daffa261109/twotrash/docs/pcb/output/pdf/02-tembaga-bawah-inspeksi.pdf

# SISI TEMBAGA - HANYA UNTUK INSPEKSI

TT-PZ2 / 140 x 100 mm / single-sided copper / no mains

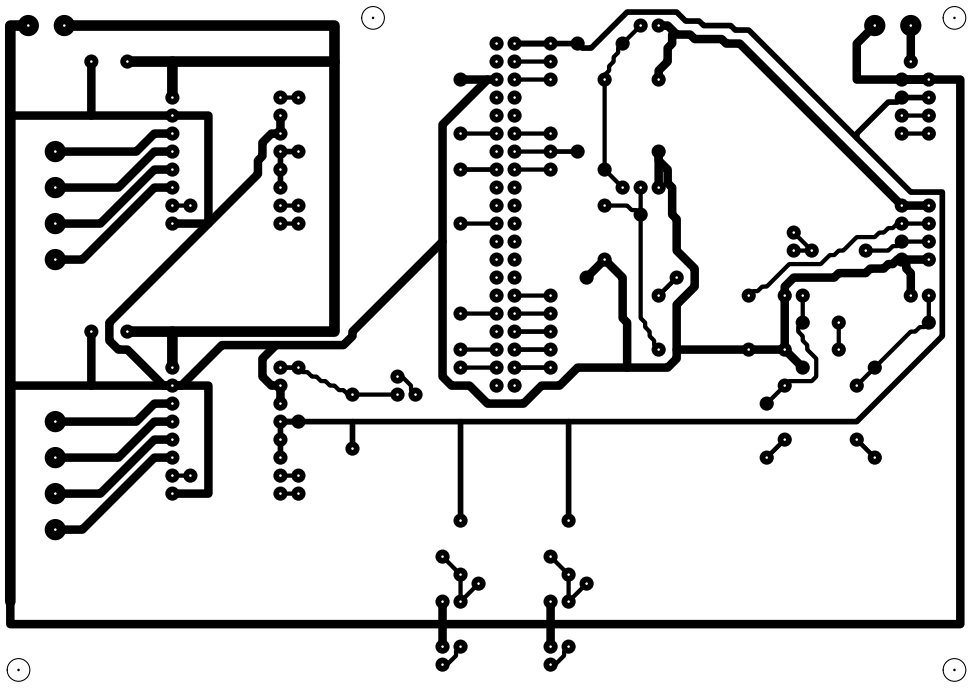
[picture p2: figure]

CALIBRATION: exactly 50 mm

Board outline 140 x 100 mm. A4 / Actual size / 100%.

Printer laser. Actual size 100%. Matikan Fit / Shrink. JANGAN mirror lagi. Hitam = tembaga dipertahankan. Titik putih kecil = pusat bor.
Bandingkan gambar ini dengan sisi tembaga SETELAH transfer.
Use 03-komponen-dan-bor.pdf for component side, drill sizes and wire jumpers. Required insulated wire jumpers: 22. Do not omit them.
Prototipe: cocokkan modul nyata dan periksa kontinuitas sebelum memberi daya.
