daffa261109/twotrash/docs/3d/external-gears/mekanisme-tanpa-flap.png

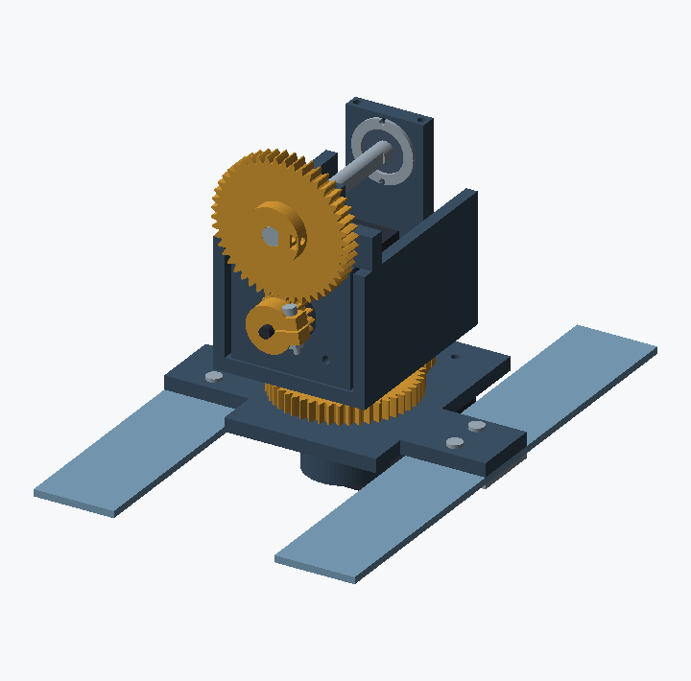
docs/3d/external-gears/mekanisme-tanpa-flap.png
