daffa261109/twotrash/docs/3d/external-gears/previews/flap-atas.png

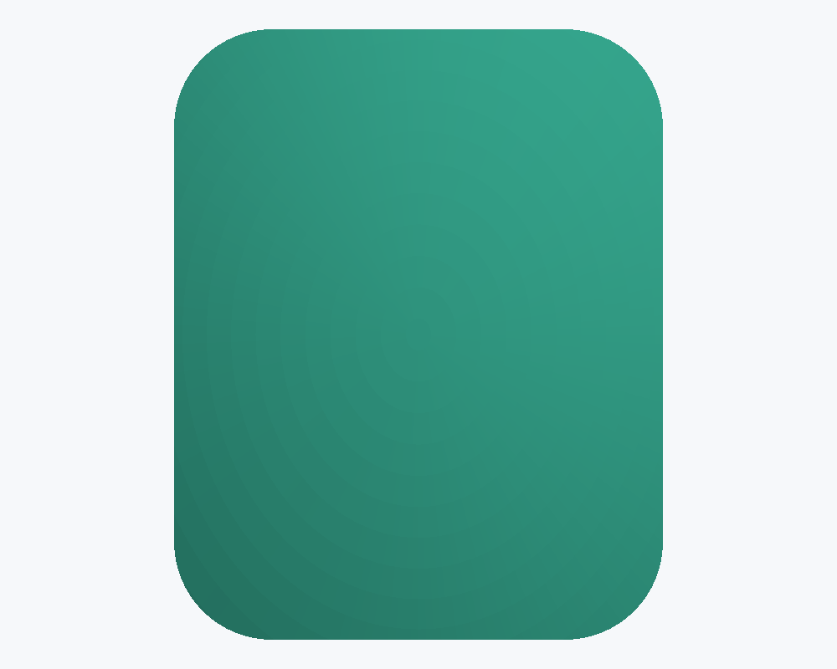
docs/3d/external-gears/previews/flap-atas.png
