daffa261109/twotrash/docs/3d/external-gears/previews/flap-bawah-miring.png

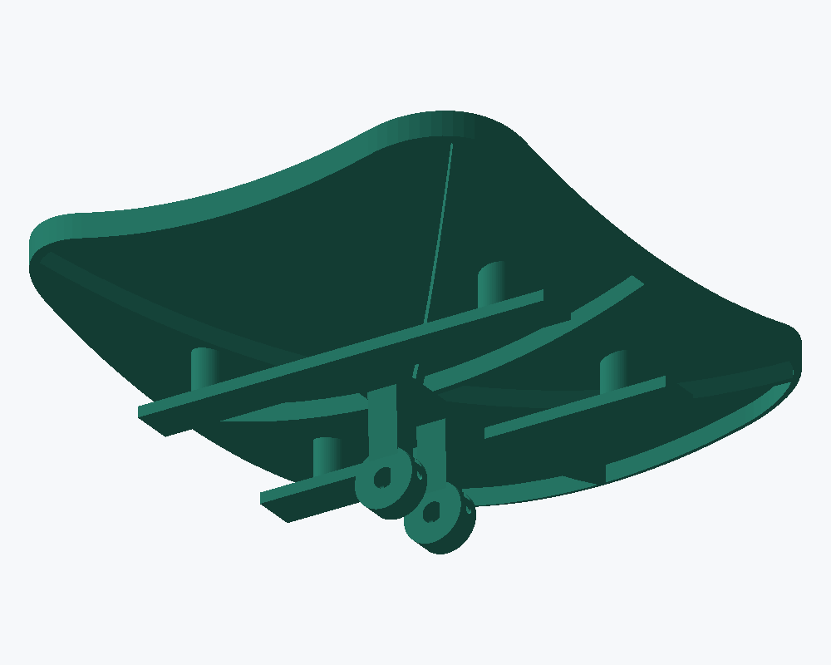
docs/3d/external-gears/previews/flap-bawah-miring.png
