daffa261109/twotrash/docs/3d/external-gears/previews/flap-miring.png

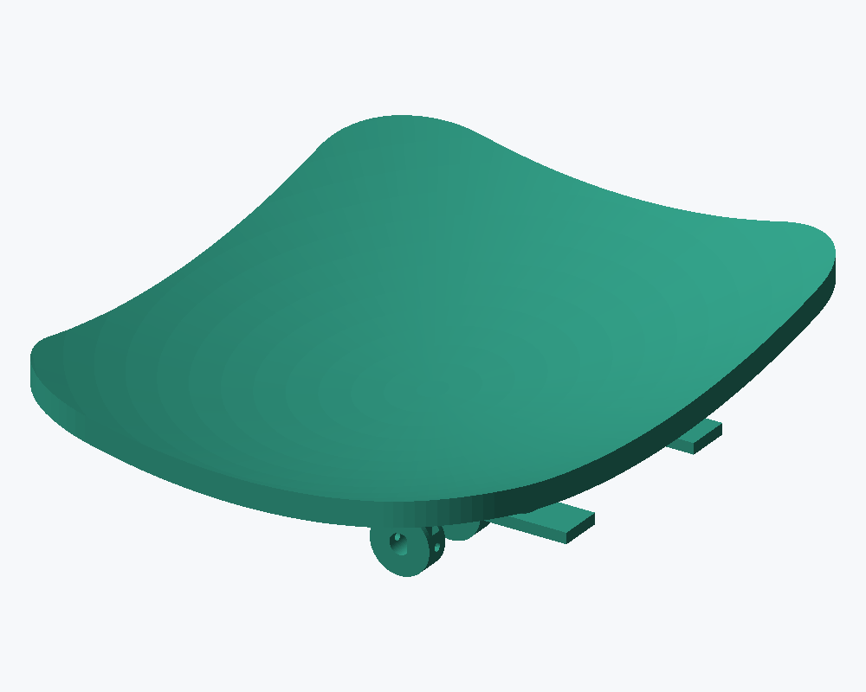
docs/3d/external-gears/previews/flap-miring.png
