daffa261109/twotrash/docs/3d/external-gears/previews/frame-dudukan-bak-atas.png

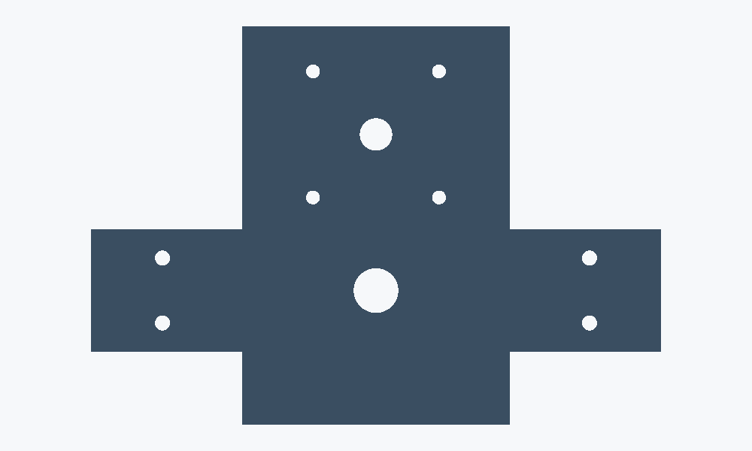
docs/3d/external-gears/previews/frame-dudukan-bak-atas.png
