daffa261109/twotrash/docs/3d/external-gears/previews/pinion-poros-bulat.png

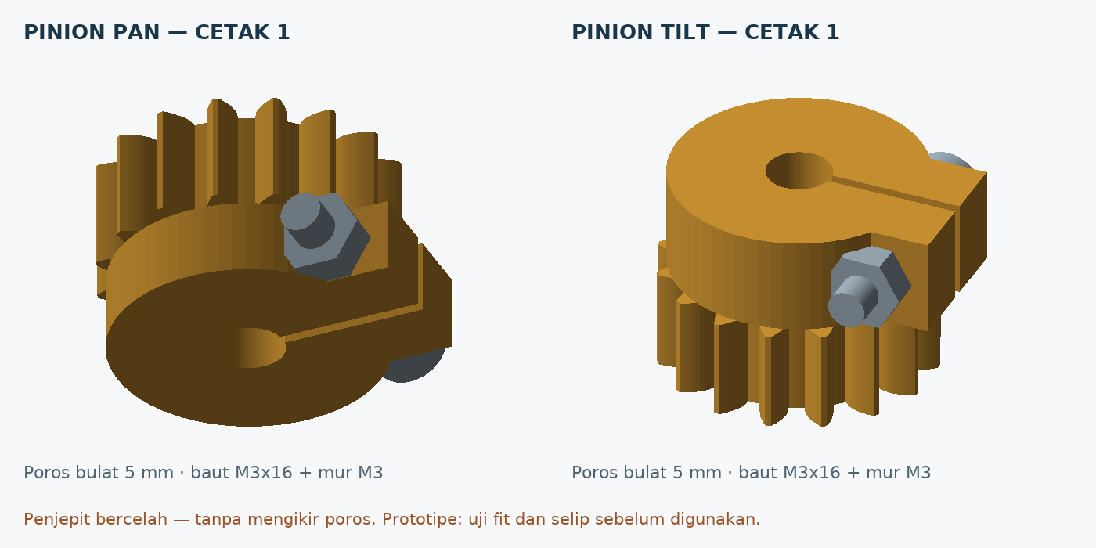
docs/3d/external-gears/previews/pinion-poros-bulat.png
