daffa261109/twotrash/docs/3d/external-gears/rakitan-3d.png

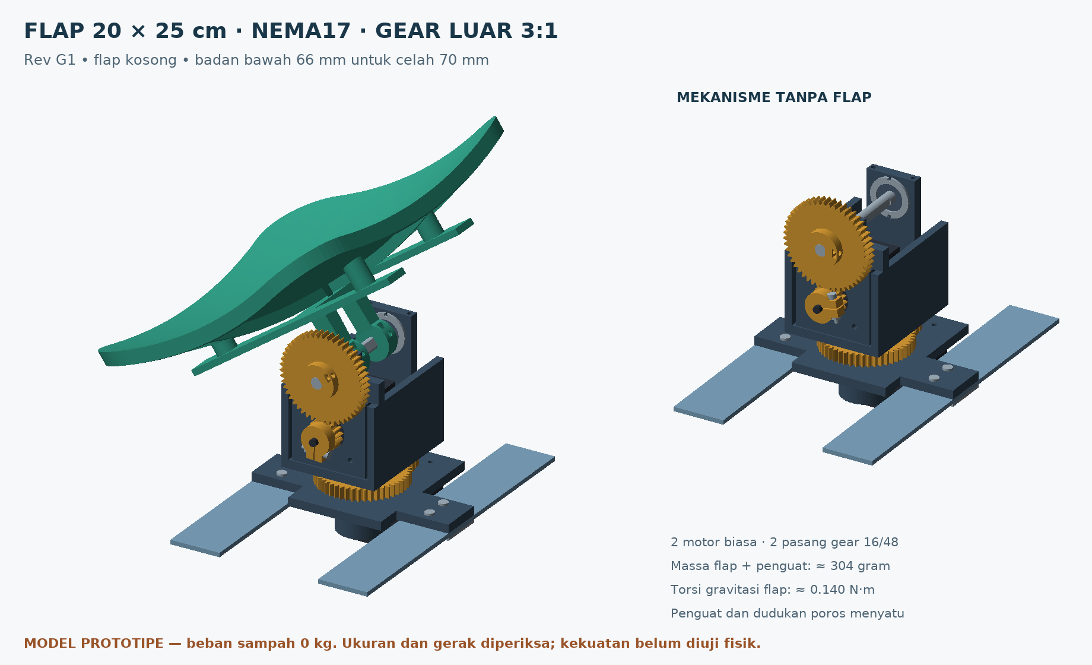
docs/3d/external-gears/rakitan-3d.png
