daffa261109/twotrash/docs/pcb/previews/01-transfer-toner-1to1-p1.png

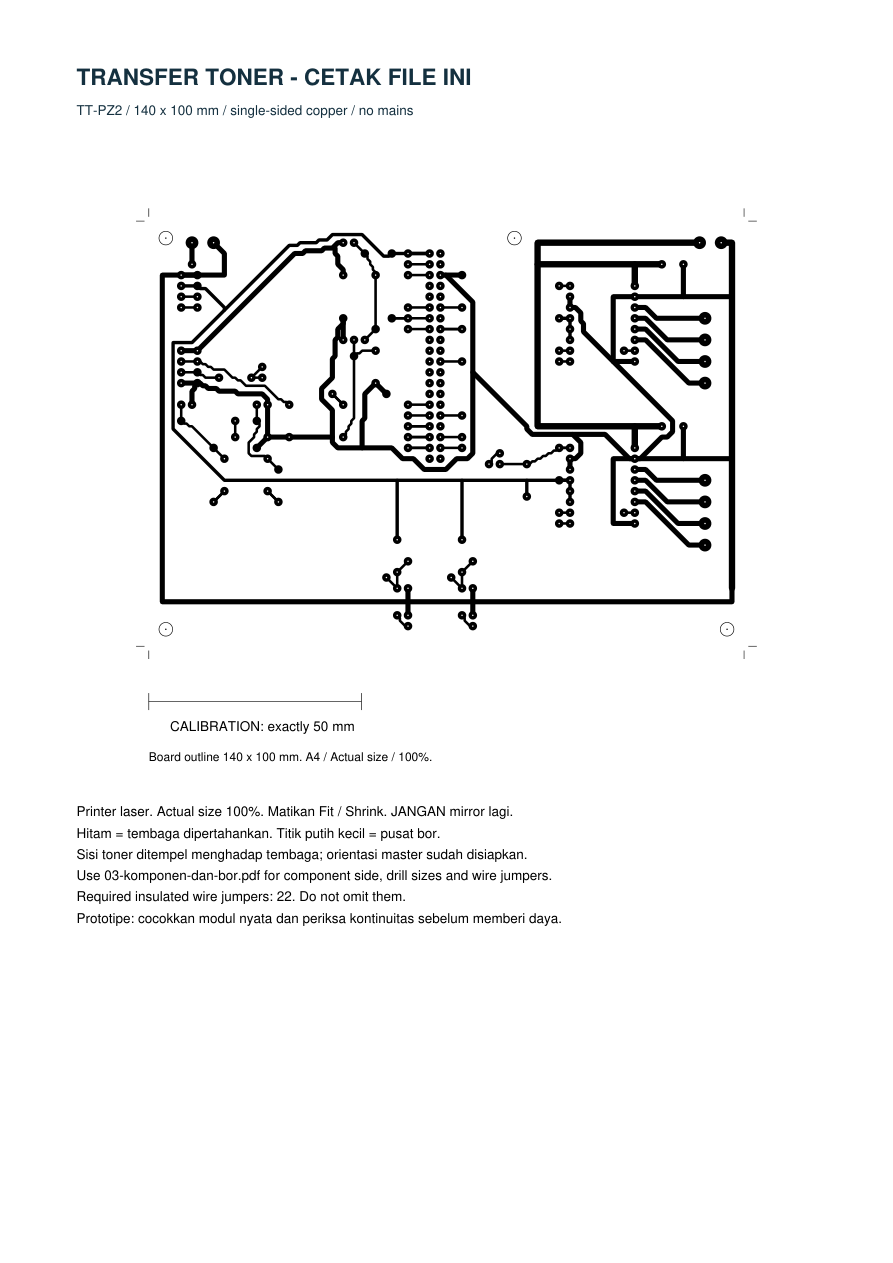
docs/pcb/previews/01-transfer-toner-1to1-p1.png
