daffa261109/twotrash/docs/pcb/previews/02-tembaga-bawah-inspeksi-p1.png

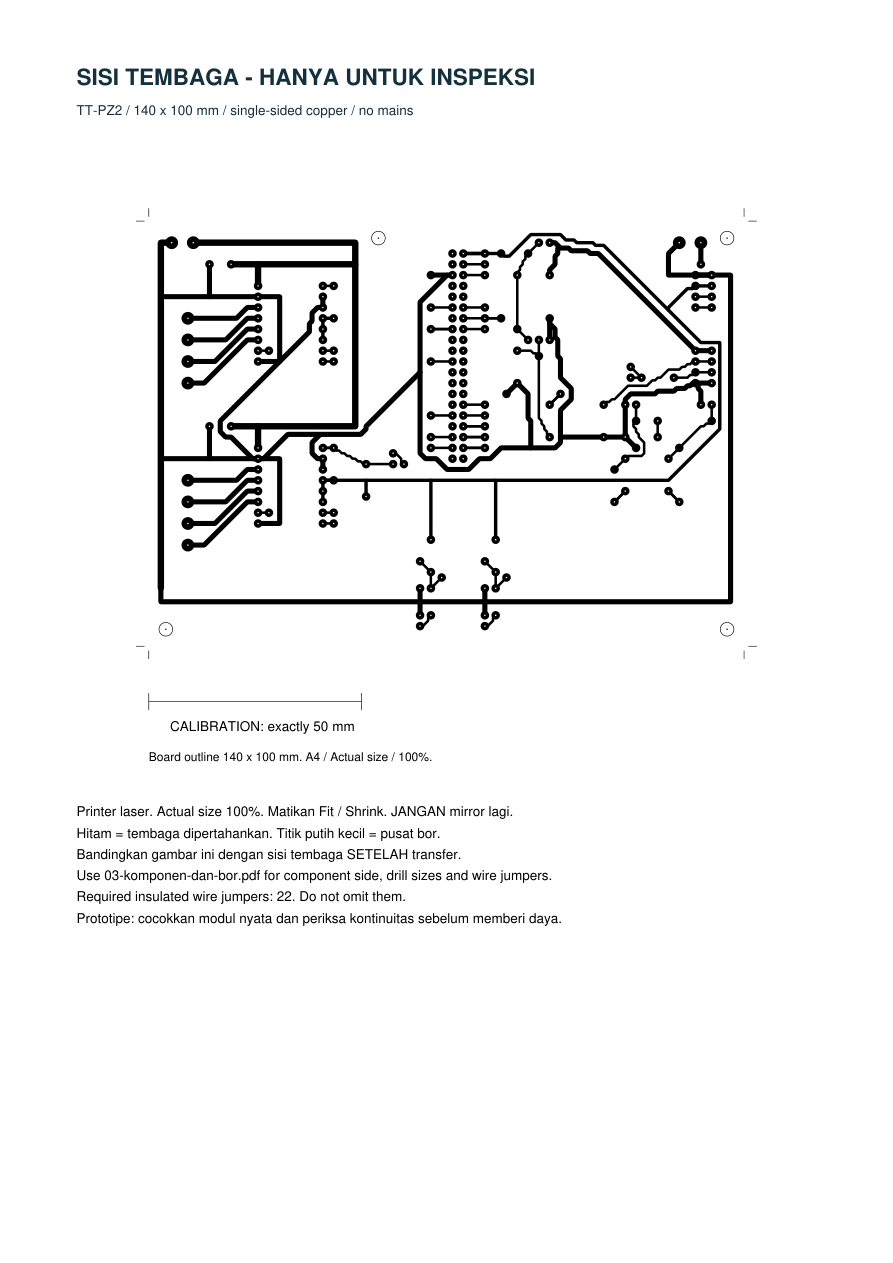
docs/pcb/previews/02-tembaga-bawah-inspeksi-p1.png
