daffa261109/twotrash/docs/pcb/previews/03-komponen-dan-bor-p4.png

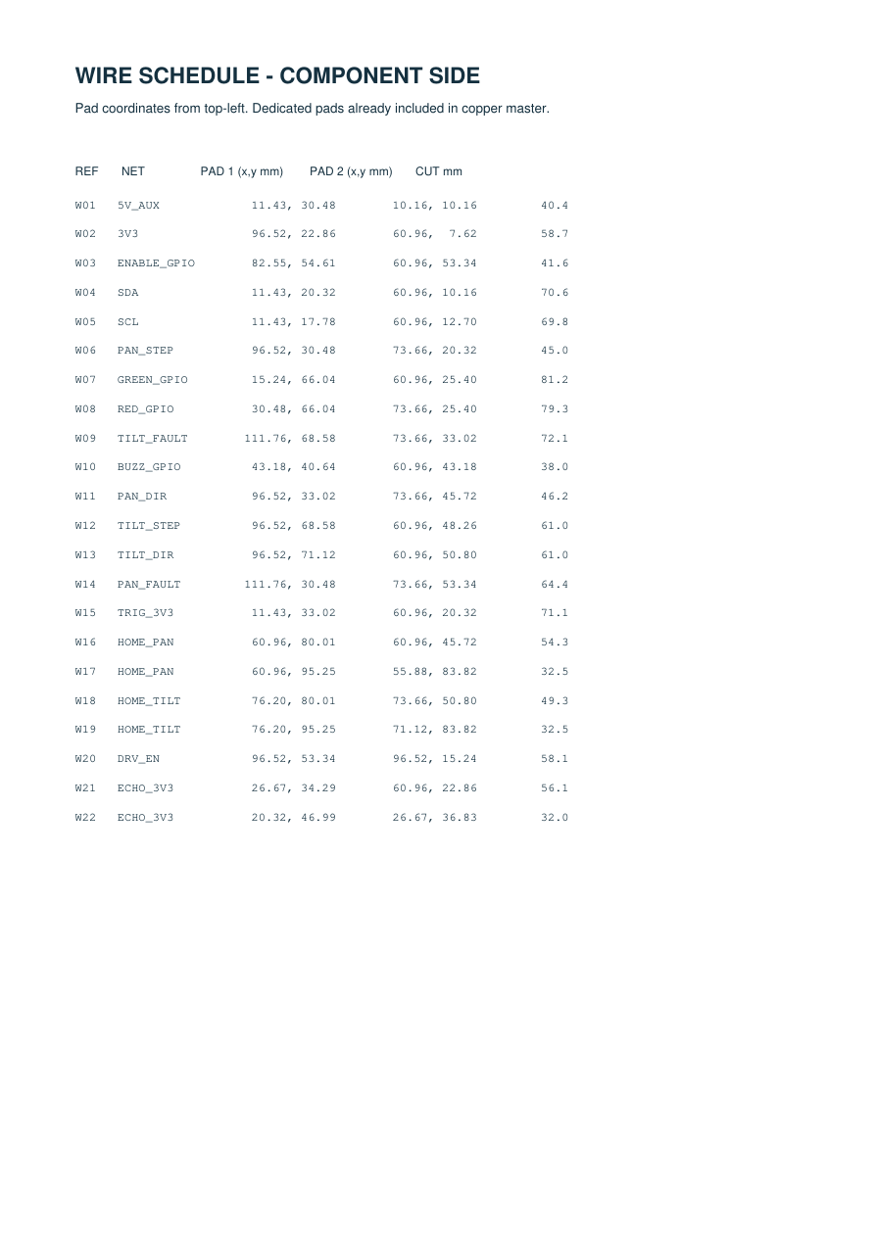
docs/pcb/previews/03-komponen-dan-bor-p4.png
