daffa261109/twotrash/docs/pcb/previews/03-komponen-dan-bor-p5.png

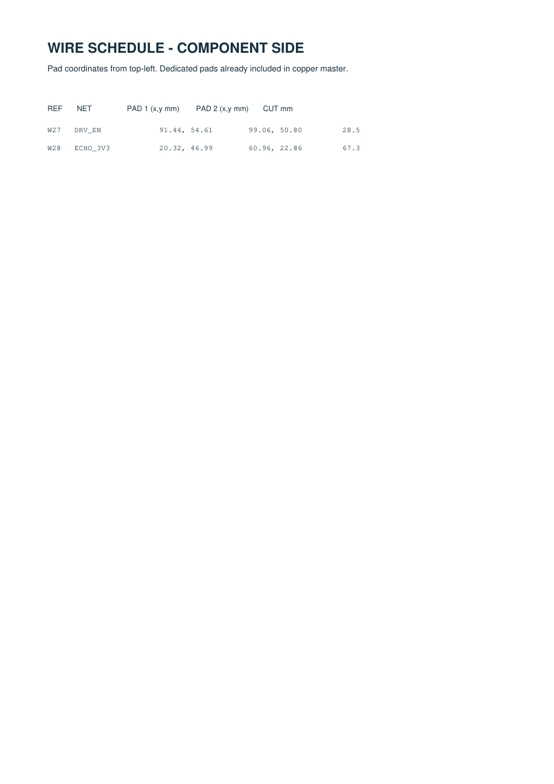
docs/pcb/previews/03-komponen-dan-bor-p5.png
