daffa261109/twotrash/docs/pcb/previews/04-peta-komponen-jelas-p2.png

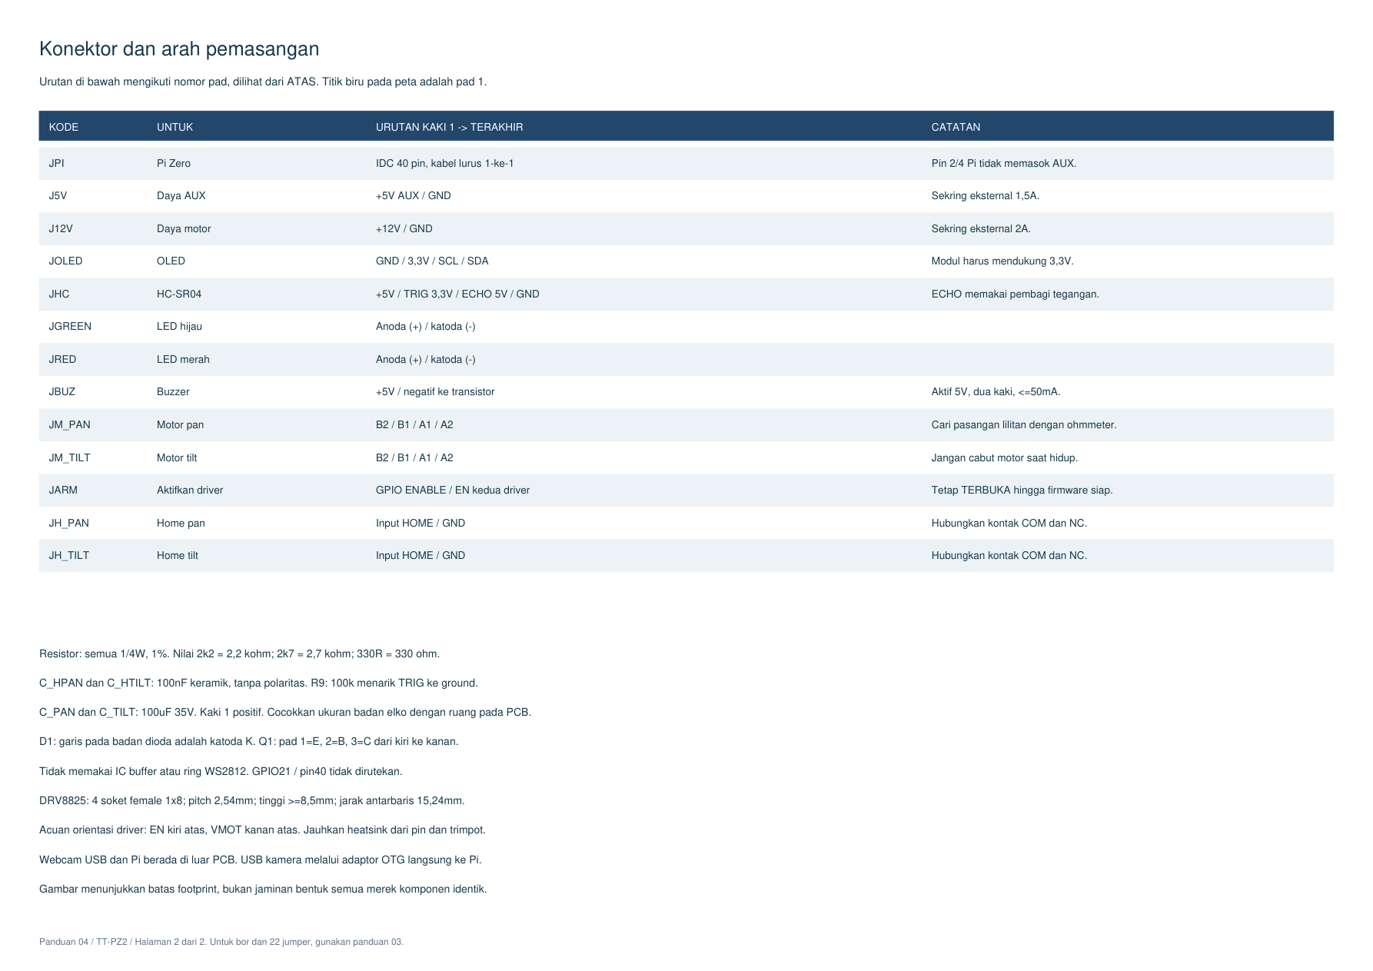
docs/pcb/previews/04-peta-komponen-jelas-p2.png
