daffa261109/twotrash/docs/pcb/previews/pcb-atas.png

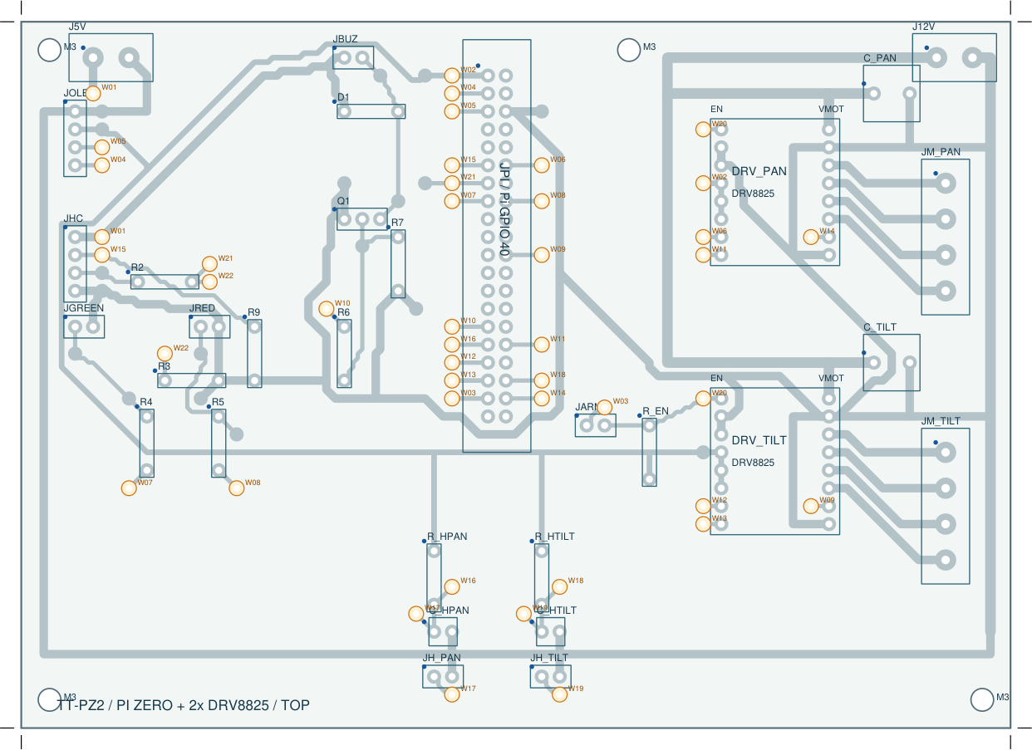
docs/pcb/previews/pcb-atas.png
