daffa261109/twotrash/docs/3d/external-gears/stl/caps.stl

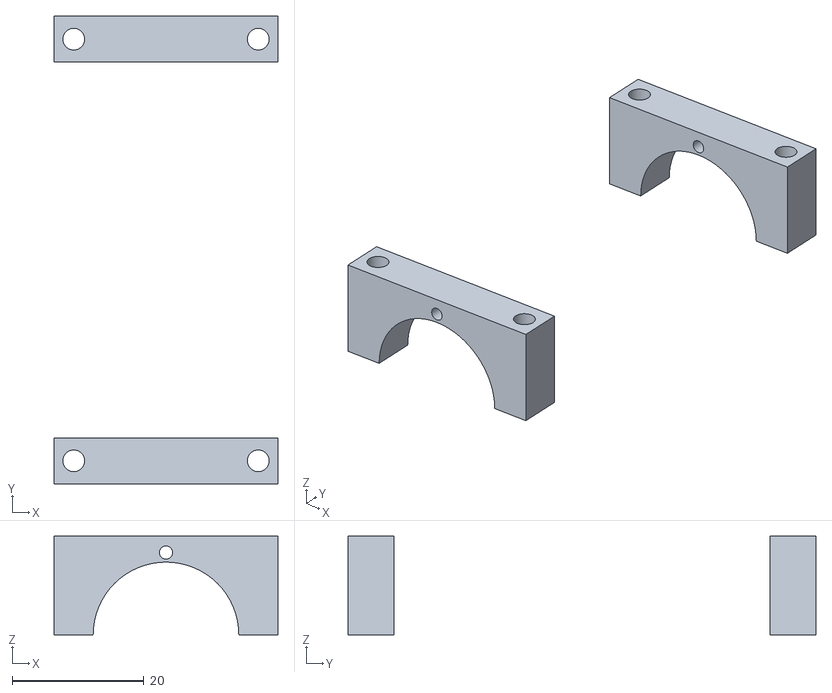
[picture p21: CAD file, 2026-10-26]
docs/3d/external-gears/stl/caps.stl
34.0 x 71.0 x 15.0
