daffa261109/twotrash/docs/3d/external-gears/stl/cetak/frame.stl

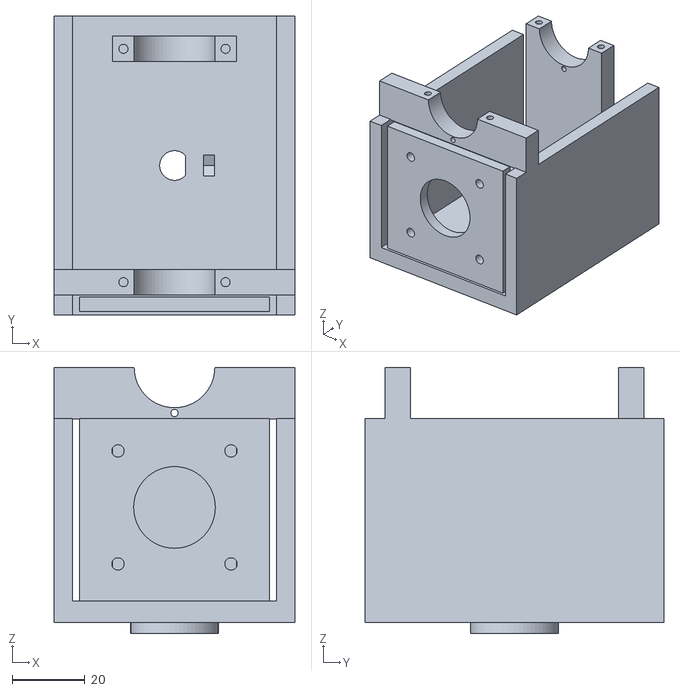
[picture p22: CAD file, 2026-10-26]
docs/3d/external-gears/stl/cetak/frame.stl
66.0 x 82.0 x 73.0
