daffa261109/twotrash/docs/3d/external-gears/stl/referensi/pinion_tilt_fastener.stl

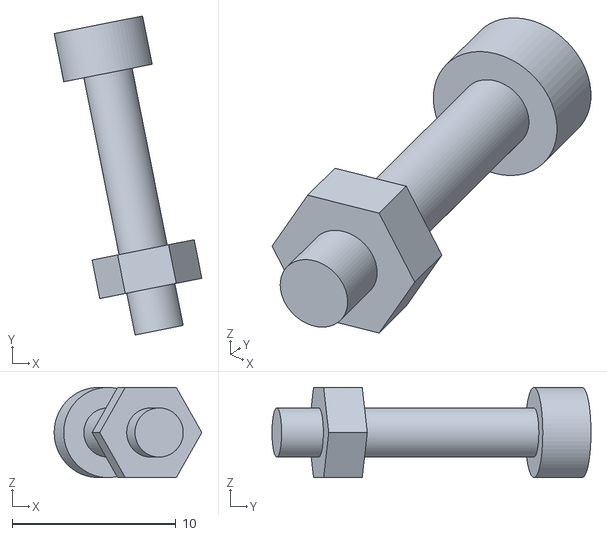
[picture p23: CAD file, 2026-10-26]
docs/3d/external-gears/stl/referensi/pinion_tilt_fastener.stl
9.01 x 19.5 x 5.50
