daffa261109/twotrash/docs/3d/flap-besi-tilt/stl/flap.stl

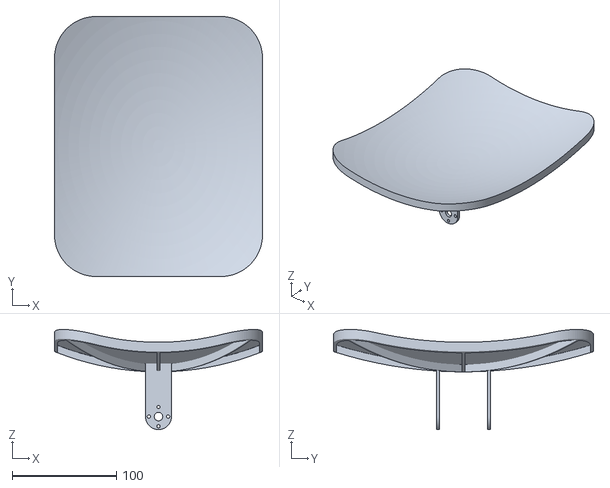
[picture p24: CAD file, 2026-10-26]
docs/3d/flap-besi-tilt/stl/flap.stl
200.0 x 250.0 x 96.3
