daffa261109/twotrash/docs/3d/flap.stl

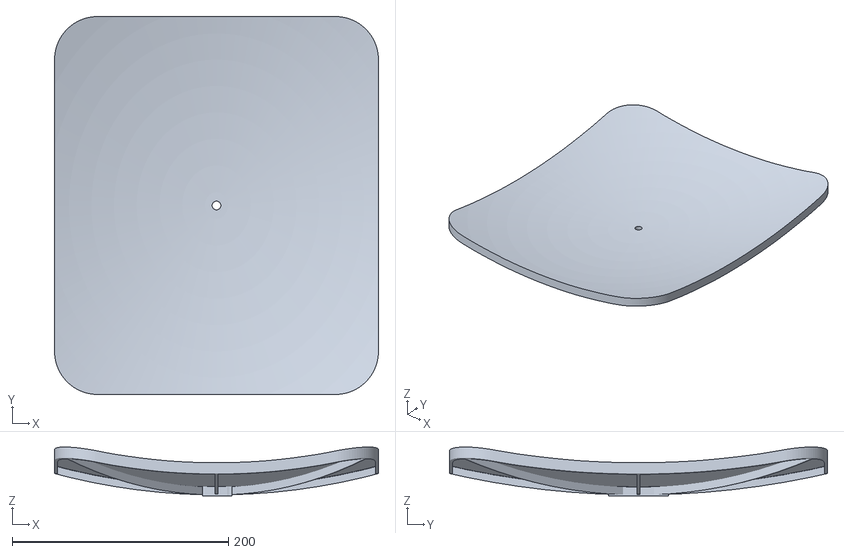
[picture p25: CAD file, 2026-10-15]
docs/3d/flap.stl
300.0 x 350.0 x 45.3
