daffa261109/twotrash/docs/3d/external-gears/stl/base_right.stl

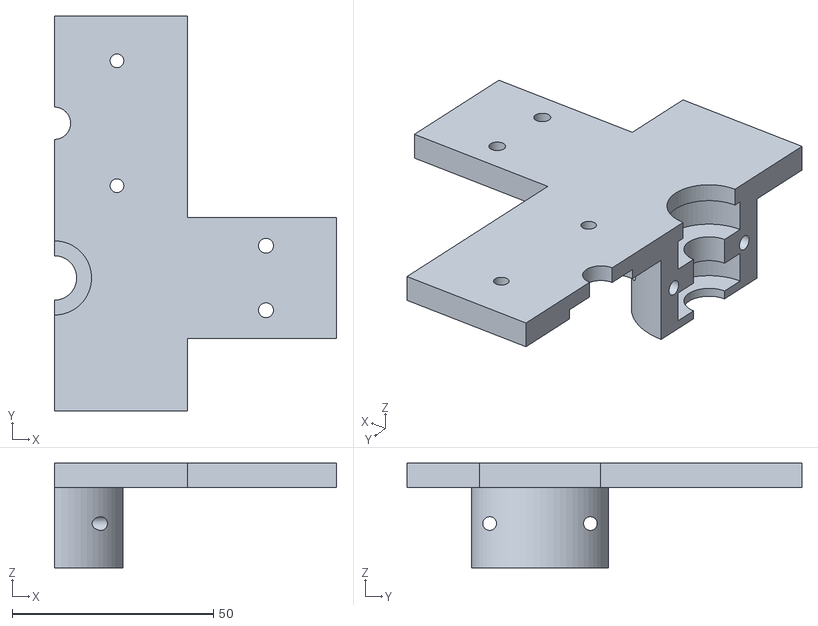
[picture p26: CAD file, 2026-10-26]
docs/3d/external-gears/stl/base_right.stl
70.0 x 98.0 x 26.0
