daffa261109/twotrash/docs/3d/external-gears/stl/cetak/retainers.stl

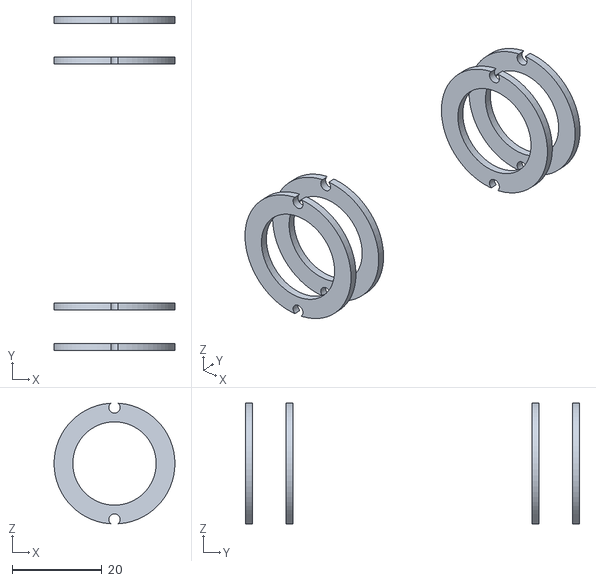
[picture p27: CAD file, 2026-10-26]
docs/3d/external-gears/stl/cetak/retainers.stl
27.0 x 74.6 x 26.9
