daffa261109/twotrash/docs/3d/external-gears/stl/referensi/tilt_bearings.stl

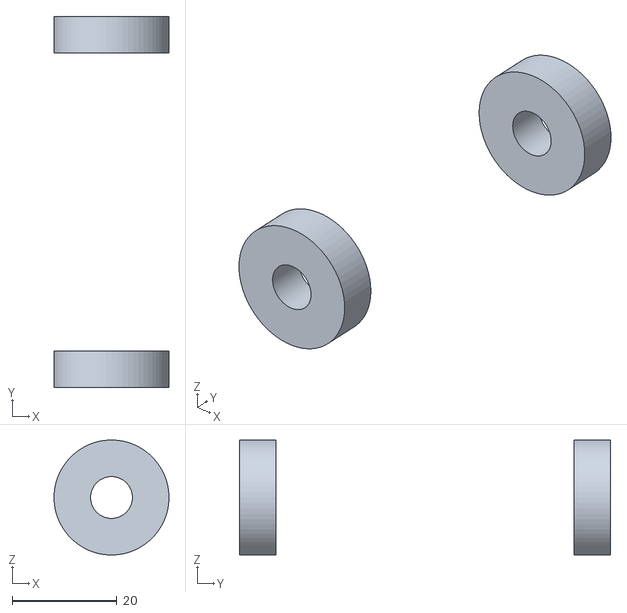
[picture p28: CAD file, 2026-10-26]
docs/3d/external-gears/stl/referensi/tilt_bearings.stl
22.0 x 71.0 x 22.0
