daffa261109/twotrash/docs/3d/external-gears/stl/cetak/pinion_tilt.stl

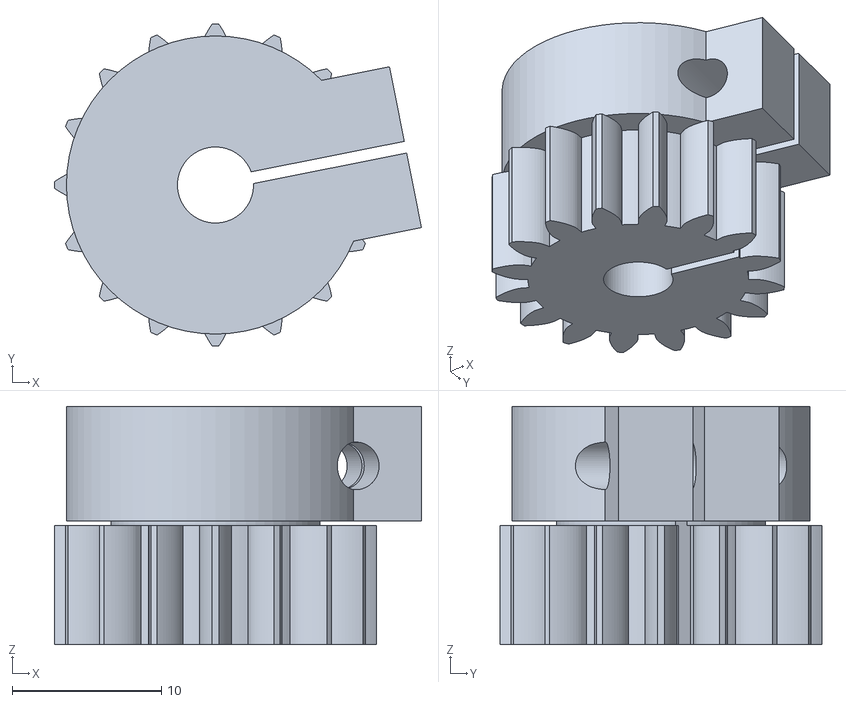
[picture p29: CAD file, 2026-10-26]
docs/3d/external-gears/stl/cetak/pinion_tilt.stl
24.6 x 21.6 x 16.0
