daffa261109/twotrash/docs/3d/external-gears/stl/referensi/rails.stl

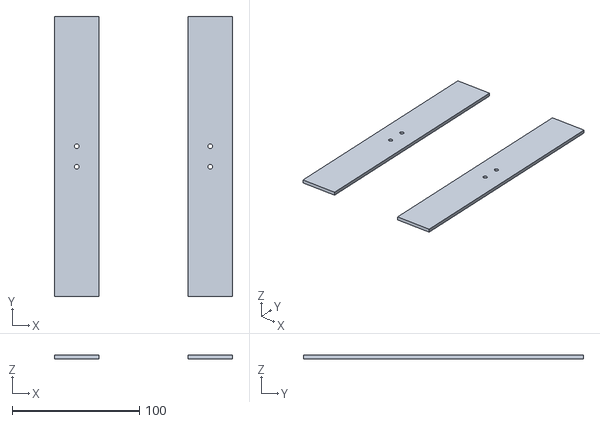
[picture p30: CAD file, 2026-10-26]
docs/3d/external-gears/stl/referensi/rails.stl
140.0 x 220.0 x 3.00
