daffa261109/twotrash/docs/3d/external-gears/stl/cetak/pinion_pan.stl

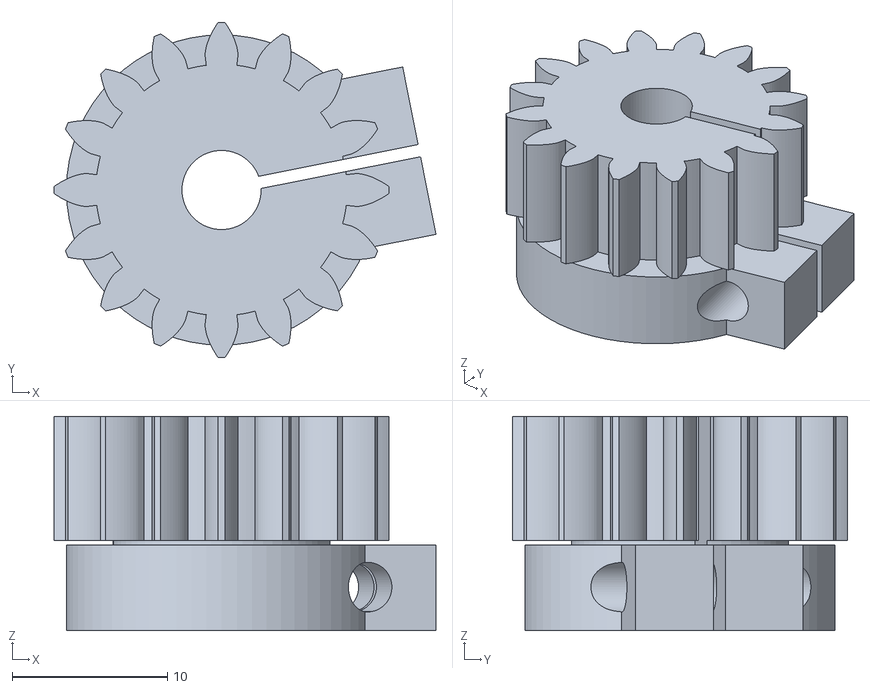
[picture p31: CAD file, 2026-10-26]
docs/3d/external-gears/stl/cetak/pinion_pan.stl
24.6 x 21.6 x 13.8
