daffa261109/twotrash/docs/3d/external-gears/stl/flap.stl

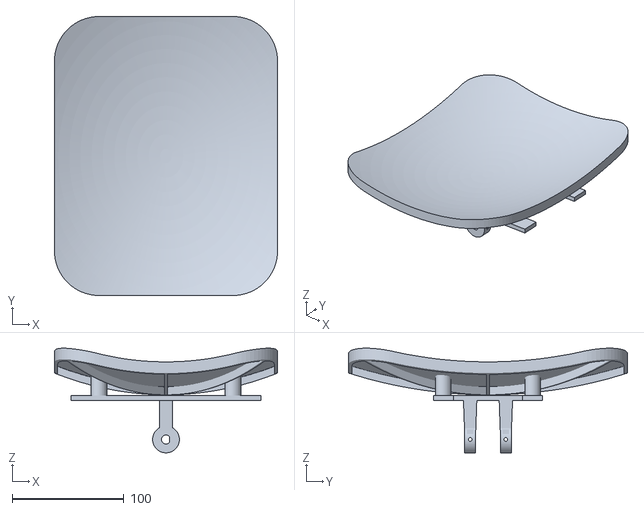
[picture p32: CAD file, 2026-10-26]
docs/3d/external-gears/stl/flap.stl
200.0 x 250.0 x 93.8
