daffa261109/twotrash/docs/3d/external-gears/stl/referensi/tilt_collar.stl

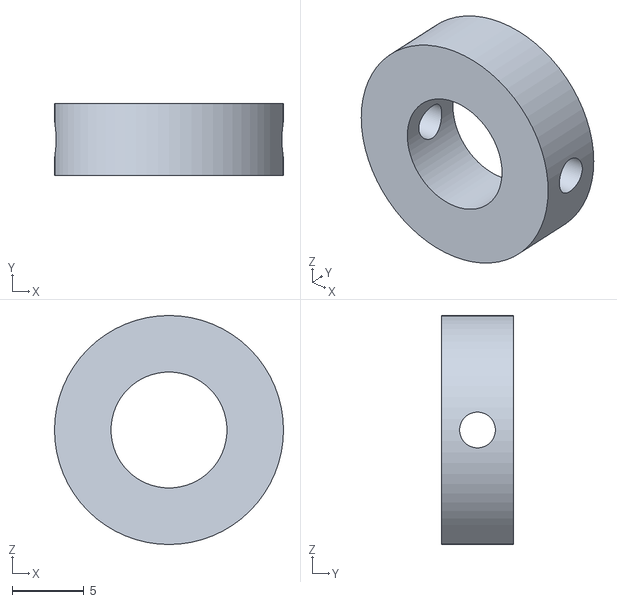
[picture p33: CAD file, 2026-10-26]
docs/3d/external-gears/stl/referensi/tilt_collar.stl
16.0 x 5.00 x 16.0
