daffa261109/twotrash/docs/3d/external-gears/stl/pan_collars.stl

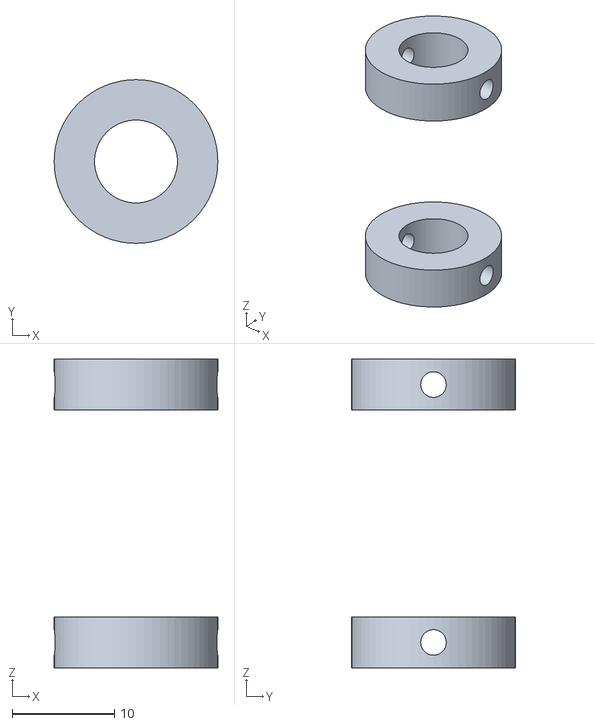
[picture p34: CAD file, 2026-10-26]
docs/3d/external-gears/stl/pan_collars.stl
16.0 x 16.0 x 30.2
