daffa261109/twotrash/docs/3d/external-gears/stl/driven.stl

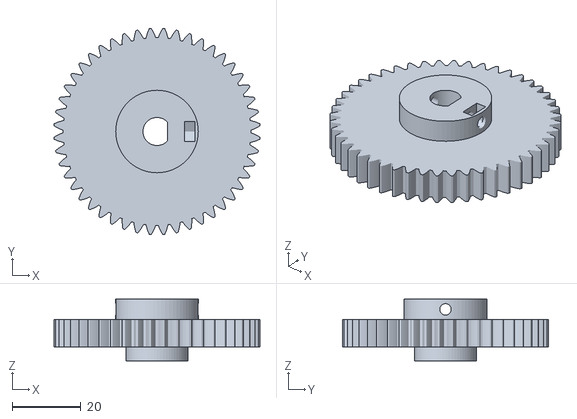
[picture p35: CAD file, 2026-10-26]
docs/3d/external-gears/stl/driven.stl
59.9 x 59.9 x 18.0
