daffa261109/twotrash/docs/3d/external-gears/stl/referensi/rivets.stl

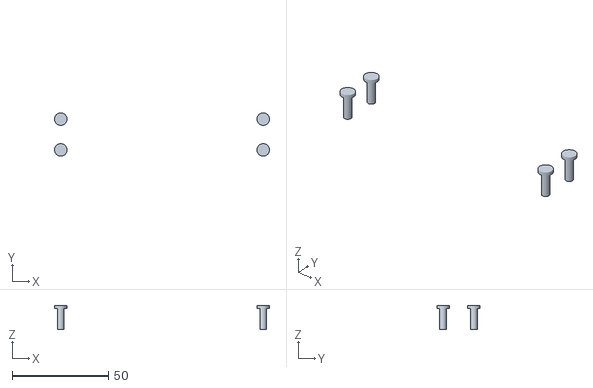
[picture p36: CAD file, 2026-10-26]
docs/3d/external-gears/stl/referensi/rivets.stl
111.5 x 22.5 x 12.5
