daffa261109/twotrash/docs/3d/external-gears/stl/pinion.stl

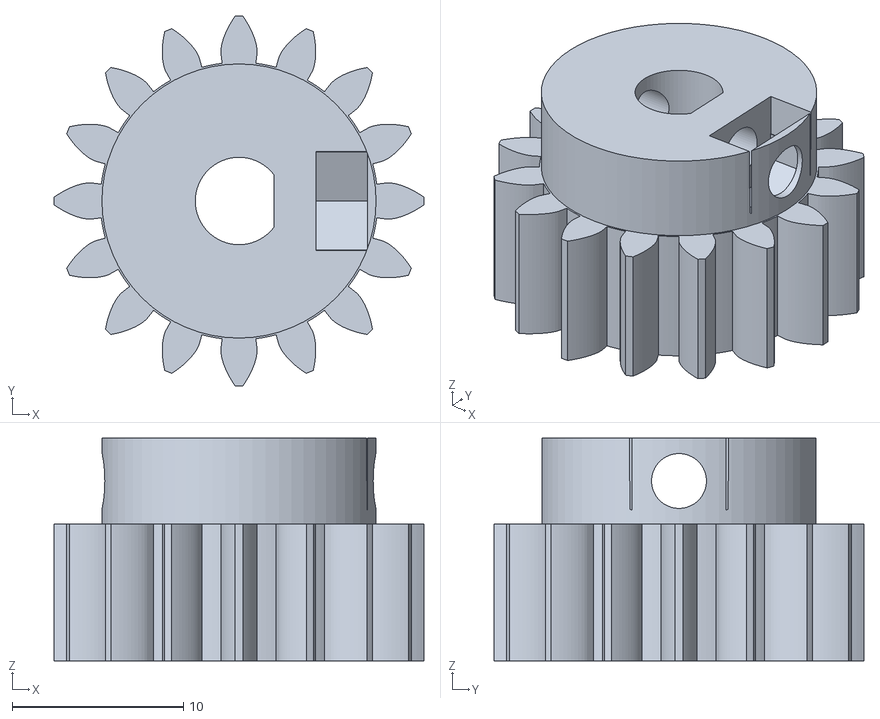
[picture p37: CAD file, 2026-10-26]
docs/3d/external-gears/stl/pinion.stl
21.6 x 21.6 x 13.0
