daffa261109/twotrash/docs/3d/external-gears/stl/referensi/pan_bearings.stl

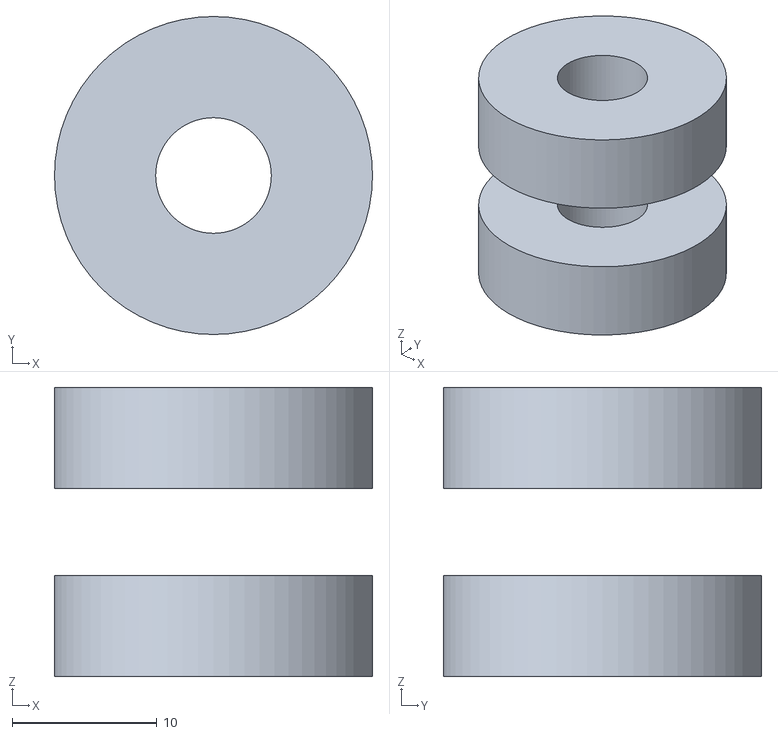
[picture p38: CAD file, 2026-10-26]
docs/3d/external-gears/stl/referensi/pan_bearings.stl
22.0 x 22.0 x 20.0
