daffa261109/twotrash/docs/3d/external-gears/stl/motor.stl

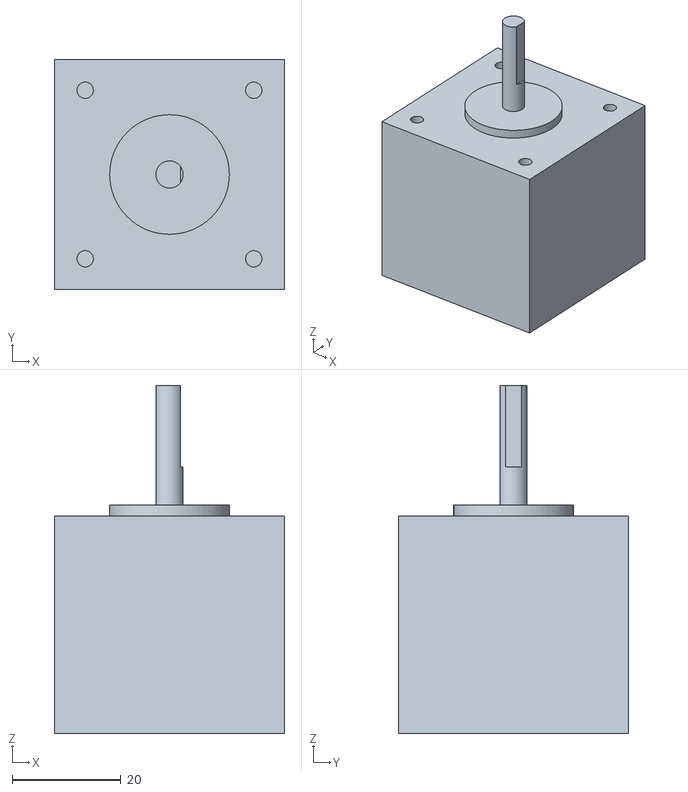
[picture p39: CAD file, 2026-10-26]
docs/3d/external-gears/stl/motor.stl
42.3 x 42.3 x 64.0
