daffa261109/twotrash/docs/3d/external-gears/stl/referensi/tilt_shaft.stl

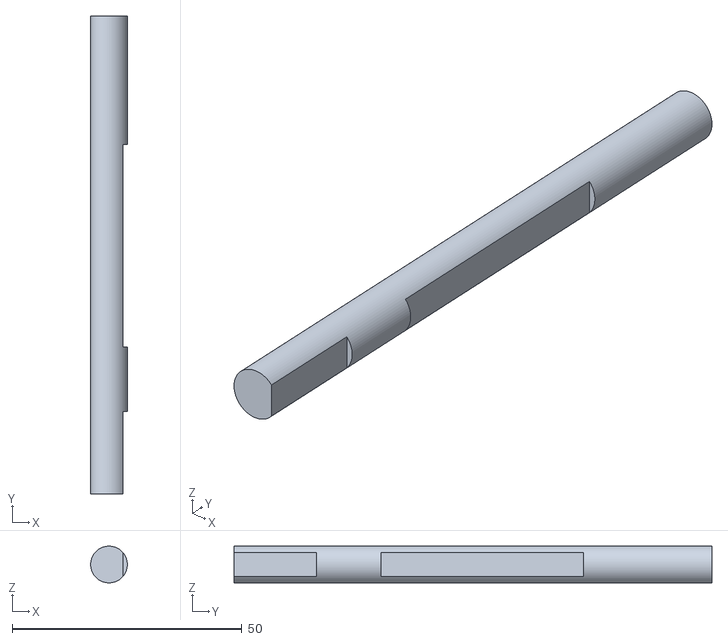
[picture p40: CAD file, 2026-10-26]
docs/3d/external-gears/stl/referensi/tilt_shaft.stl
8.00 x 104.0 x 8.00
