daffa261109/twotrash/docs/3d/external-gears/stl/referensi/pan_shaft.stl

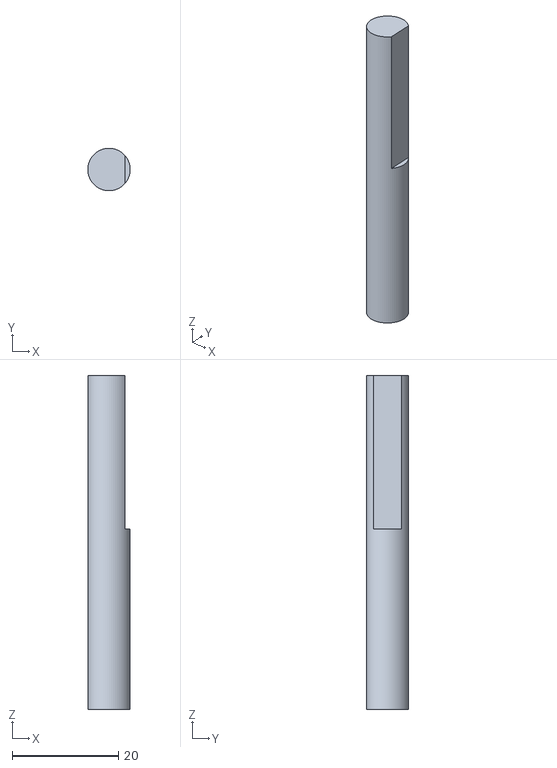
[picture p41: CAD file, 2026-10-26]
docs/3d/external-gears/stl/referensi/pan_shaft.stl
8.00 x 8.00 x 63.0
