daffa261109/twotrash/docs/3d/external-gears/stl/tray_only.stl

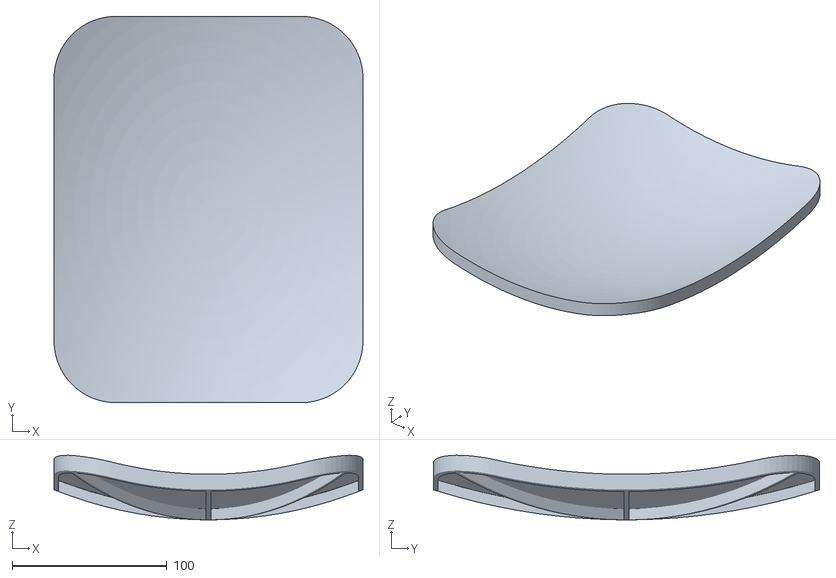
[picture p42: CAD file, 2026-10-26]
docs/3d/external-gears/stl/tray_only.stl
200.0 x 250.0 x 41.8
