daffa261109/twotrash/docs/3d/external-gears/stl/referensi/flange.stl

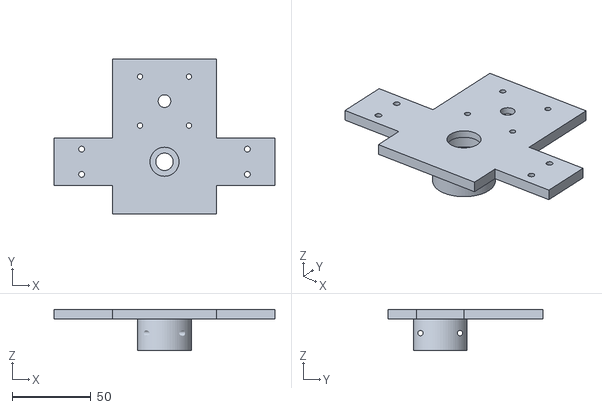
[picture p43: CAD file, 2026-10-26]
docs/3d/external-gears/stl/referensi/flange.stl
140.0 x 98.0 x 26.0
