daffa261109/twotrash/docs/3d/external-gears/stl/referensi/motor.stl

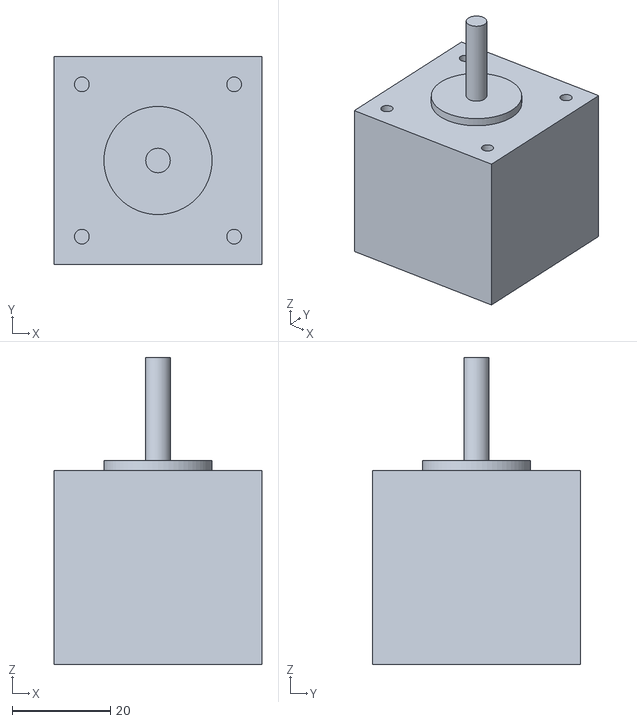
[picture p44: CAD file, 2026-10-26]
docs/3d/external-gears/stl/referensi/motor.stl
42.3 x 42.3 x 62.5
