daffa261109/twotrash/docs/3d/external-gears/stl/referensi/backplates.stl

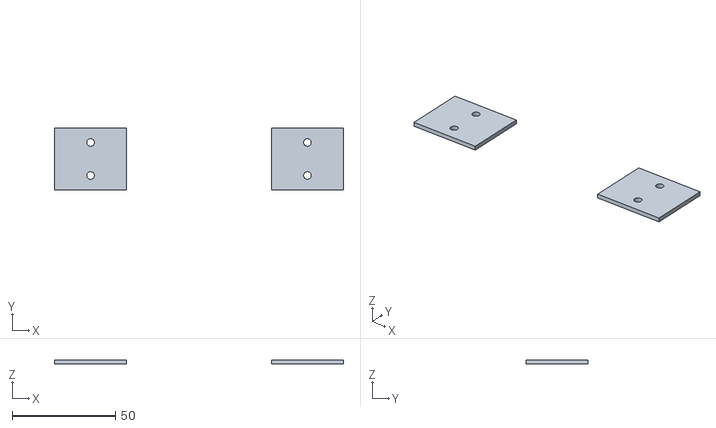
[picture p45: CAD file, 2026-10-26]
docs/3d/external-gears/stl/referensi/backplates.stl
140.0 x 30.0 x 2.00
