daffa261109/twotrash/docs/3d/external-gears/gear_profiles.scad

// Module1.2, PA25, backlash .12 per member; external spur gears.
module pinion_profile(){polygon(points=[[8.039893,-0.9849474],[8.2460441,-1.0102024],[8.4521952,-1.0354575],[8.6584777,-1.0596387],[8.8687813,-1.0504084],[9.0817273,-1.0167149],[9.2961884,-0.9651282],[9.5115413,-0.8980859],[9.7272944,-0.8169316],[9.9430137,-0.7225244],[10.1582955,-0.6154637],[10.3727541,-0.4961936],[10.586015,-0.3650591],[10.7977111,-0.2223398],[10.7994278,-0.1111758],[10.8,0.0],[10.7994278,0.1111758],[10.7977111,0.2223398],[10.586015,0.3650591],[10.3727541,0.4961936],[10.1582955,0.6154637],[9.9430137,0.7225244],[9.7272944,0.8169316],[9.5115413,0.8980859],[9.2961884,0.9651282],[9.0817273,1.0167149],[8.8687813,1.0504084],[8.6584777,1.0596387],[8.4521952,1.0354575],[8.2460441,1.0102024],[8.039893,0.9849474],[7.9976673,1.2834786],[7.9443608,1.5802316],[7.8800472,1.8747951],[7.8048156,2.1667611],[8.0049391,2.2223191],[8.2050625,2.2778771],[8.4048965,2.3344775],[8.5956594,2.4234849],[8.7795019,2.5361045],[8.9578968,2.6658351],[9.1312009,2.8101861],[9.2994744,2.967728],[9.4626449,3.1375011],[9.6205691,3.318797],[9.7730603,3.5110581],[9.9199047,3.7138219],[10.06087,3.92669],[10.0199154,4.030049],[9.977899,4.1329811],[9.9348251,4.2354751],[9.8906985,4.3375203],[9.6405005,4.3883632],[9.3932902,4.4279043],[9.1495135,4.4560257],[8.9096487,4.4725521],[8.674222,4.4772208],[8.4438358,4.4696324],[8.2192197,4.4491594],[8.001342,4.4147486],[7.7917116,4.3643864],[7.5938842,4.2924345],[7.4125577,4.191153],[7.2317636,4.0889298],[7.0509695,3.9867065],[6.8977151,4.2463544],[6.7349039,4.5001189],[6.5627612,4.7476484],[6.3815258,4.9885999],[6.5451547,5.1165127],[6.7087835,5.2444255],[6.871746,5.3731906],[7.0139263,5.5284245],[7.1406769,5.7028249],[7.2558465,5.8909492],[7.360718,6.0906327],[7.4558937,6.300578],[7.5416743,6.5198705],[7.6181982,6.7478011],[7.6855066,6.983783],[7.7435788,7.2273072],[7.7923527,7.4779168],[7.7149618,7.5577354],[7.6367532,7.6367532],[7.5577354,7.7149618],[7.4779168,7.7923527],[7.2273072,7.7435788],[6.983783,7.6855066],[6.7478011,7.6181982],[6.5198705,7.5416743],[6.300578,7.4558937],[6.0906327,7.360718],[5.8909492,7.2558465],[5.7028249,7.1406769],[5.5284245,7.0139263],[5.3731906,6.871746],[5.2444255,6.7087835],[5.1165127,6.5451547],[4.9885999,6.3815258],[4.7476484,6.5627612],[4.5001189,6.7349039],[4.2463544,6.8977151],[3.9867065,7.0509695],[4.0889298,7.2317636],[4.191153,7.4125577],[4.2924345,7.5938842],[4.3643864,7.7917116],[4.4147486,8.001342],[4.4491594,8.2192197],[4.4696324,8.4438358],[4.4772208,8.674222],[4.4725521,8.9096487],[4.4560257,9.1495135],[4.4279043,9.3932902],[4.3883632,9.6405005],[4.3375203,9.8906985],[4.2354751,9.9348251],[4.1329811,9.977899],[4.030049,10.0199154],[3.92669,10.06087],[3.7138219,9.9199047],[3.5110581,9.7730603],[3.318797,9.6205691],[3.1375011,9.4626449],[2.967728,9.2994744],[2.8101861,9.1312009],[2.6658351,8.9578968],[2.5361045,8.7795019],[2.4234849,8.5956594],[2.3344775,8.4048965],[2.2778771,8.2050625],[2.2223191,8.0049391],[2.1667611,7.8048156],[1.8747951,7.8800472],[1.5802316,7.9443608],[1.2834786,7.9976673],[0.9849474,8.039893],[1.0102024,8.2460441],[1.0354575,8.4521952],[1.0596387,8.6584777],[1.0504084,8.8687813],[1.0167149,9.0817273],[0.9651282,9.2961884],[0.8980859,9.5115413],[0.8169316,9.7272944],[0.7225244,9.9430137],[0.6154637,10.1582955],[0.4961936,10.3727541],[0.3650591,10.586015],[0.2223398,10.7977111],[0.1111758,10.7994278],[0.0,10.8],[-0.1111758,10.7994278],[-0.2223398,10.7977111],[-0.3650591,10.586015],[-0.4961936,10.3727541],[-0.6154637,10.1582955],[-0.7225244,9.9430137],[-0.8169316,9.7272944],[-0.8980859,9.5115413],[-0.9651282,9.2961884],[-1.0167149,9.0817273],[-1.0504084,8.8687813],[-1.0596387,8.6584777],[-1.0354575,8.4521952],[-1.0102024,8.2460441],[-0.9849474,8.039893],[-1.2834786,7.9976673],[-1.5802316,7.9443608],[-1.8747951,7.8800472],[-2.1667611,7.8048156],[-2.2223191,8.0049391],[-2.2778771,8.2050625],[-2.3344775,8.4048965],[-2.4234849,8.5956594],[-2.5361045,8.7795019],[-2.6658351,8.9578968],[-2.8101861,9.1312009],[-2.967728,9.2994744],[-3.1375011,9.4626449],[-3.318797,9.6205691],[-3.5110581,9.7730603],[-3.7138219,9.9199047],[-3.92669,10.06087],[-4.030049,10.0199154],[-4.1329811,9.977899],[-4.2354751,9.9348251],[-4.3375203,9.8906985],[-4.3883632,9.6405005],[-4.4279043,9.3932902],[-4.4560257,9.1495135],[-4.4725521,8.9096487],[-4.4772208,8.674222],[-4.4696324,8.4438358],[-4.4491594,8.2192197],[-4.4147486,8.001342],[-4.3643864,7.7917116],[-4.2924345,7.5938842],[-4.191153,7.4125577],[-4.0889298,7.2317636],[-3.9867065,7.0509695],[-4.2463544,6.8977151],[-4.5001189,6.7349039],[-4.7476484,6.5627612],[-4.9885999,6.3815258],[-5.1165127,6.5451547],[-5.2444255,6.7087835],[-5.3731906,6.871746],[-5.5284245,7.0139263],[-5.7028249,7.1406769],[-5.8909492,7.2558465],[-6.0906327,7.360718],[-6.300578,7.4558937],[-6.5198705,7.5416743],[-6.7478011,7.6181982],[-6.983783,7.6855066],[-7.2273072,7.7435788],[-7.4779168,7.7923527],[-7.5577354,7.7149618],[-7.6367532,7.6367532],[-7.7149618,7.5577354],[-7.7923527,7.4779168],[-7.7435788,7.2273072],[-7.6855066,6.983783],[-7.6181982,6.7478011],[-7.5416743,6.5198705],[-7.4558937,6.300578],[-7.360718,6.0906327],[-7.2558465,5.8909492],[-7.1406769,5.7028249],[-7.0139263,5.5284245],[-6.871746,5.3731906],[-6.7087835,5.2444255],[-6.5451547,5.1165127],[-6.3815258,4.9885999],[-6.5627612,4.7476484],[-6.7349039,4.5001189],[-6.8977151,4.2463544],[-7.0509695,3.9867065],[-7.2317636,4.0889298],[-7.4125577,4.191153],[-7.5938842,4.2924345],[-7.7917116,4.3643864],[-8.001342,4.4147486],[-8.2192197,4.4491594],[-8.4438358,4.4696324],[-8.674222,4.4772208],[-8.9096487,4.4725521],[-9.1495135,4.4560257],[-9.3932902,4.4279043],[-9.6405005,4.3883632],[-9.8906985,4.3375203],[-9.9348251,4.2354751],[-9.977899,4.1329811],[-10.0199154,4.030049],[-10.06087,3.92669],[-9.9199047,3.7138219],[-9.7730603,3.5110581],[-9.6205691,3.318797],[-9.4626449,3.1375011],[-9.2994744,2.967728],[-9.1312009,2.8101861],[-8.9578968,2.6658351],[-8.7795019,2.5361045],[-8.5956594,2.4234849],[-8.4048965,2.3344775],[-8.2050625,2.2778771],[-8.0049391,2.2223191],[-7.8048156,2.1667611],[-7.8800472,1.8747951],[-7.9443608,1.5802316],[-7.9976673,1.2834786],[-8.039893,0.9849474],[-8.2460441,1.0102024],[-8.4521952,1.0354575],[-8.6584777,1.0596387],[-8.8687813,1.0504084],[-9.0817273,1.0167149],[-9.2961884,0.9651282],[-9.5115413,0.8980859],[-9.7272944,0.8169316],[-9.9430137,0.7225244],[-10.1582955,0.6154637],[-10.3727541,0.4961936],[-10.586015,0.3650591],[-10.7977111,0.2223398],[-10.7994278,0.1111758],[-10.8,0.0],[-10.7994278,-0.1111758],[-10.7977111,-0.2223398],[-10.586015,-0.3650591],[-10.3727541,-0.4961936],[-10.1582955,-0.6154637],[-9.9430137,-0.7225244],[-9.7272944,-0.8169316],[-9.5115413,-0.8980859],[-9.2961884,-0.9651282],[-9.0817273,-1.0167149],[-8.8687813,-1.0504084],[-8.6584777,-1.0596387],[-8.4521952,-1.0354575],[-8.2460441,-1.0102024],[-8.039893,-0.9849474],[-7.9976673,-1.2834786],[-7.9443608,-1.5802316],[-7.8800472,-1.8747951],[-7.8048156,-2.1667611],[-8.0049391,-2.2223191],[-8.2050625,-2.2778771],[-8.4048965,-2.3344775],[-8.5956594,-2.4234849],[-8.7795019,-2.5361045],[-8.9578968,-2.6658351],[-9.1312009,-2.8101861],[-9.2994744,-2.967728],[-9.4626449,-3.1375011],[-9.6205691,-3.318797],[-9.7730603,-3.5110581],[-9.9199047,-3.7138219],[-10.06087,-3.92669],[-10.0199154,-4.030049],[-9.977899,-4.1329811],[-9.9348251,-4.2354751],[-9.8906985,-4.3375203],[-9.6405005,-4.3883632],[-9.3932902,-4.4279043],[-9.1495135,-4.4560257],[-8.9096487,-4.4725521],[-8.674222,-4.4772208],[-8.4438358,-4.4696324],[-8.2192197,-4.4491594],[-8.001342,-4.4147486],[-7.7917116,-4.3643864],[-7.5938842,-4.2924345],[-7.4125577,-4.191153],[-7.2317636,-4.0889298],[-7.0509695,-3.9867065],[-6.8977151,-4.2463544],[-6.7349039,-4.5001189],[-6.5627612,-4.7476484],[-6.3815258,-4.9885999],[-6.5451547,-5.1165127],[-6.7087835,-5.2444255],[-6.871746,-5.3731906],[-7.0139263,-5.5284245],[-7.1406769,-5.7028249],[-7.2558465,-5.8909492],[-7.360718,-6.0906327],[-7.4558937,-6.300578],[-7.5416743,-6.5198705],[-7.6181982,-6.7478011],[-7.6855066,-6.983783],[-7.7435788,-7.2273072],[-7.7923527,-7.4779168],[-7.7149618,-7.5577354],[-7.6367532,-7.6367532],[-7.5577354,-7.7149618],[-7.4779168,-7.7923527],[-7.2273072,-7.7435788],[-6.983783,-7.6855066],[-6.7478011,-7.6181982],[-6.5198705,-7.5416743],[-6.300578,-7.4558937],[-6.0906327,-7.360718],[-5.8909492,-7.2558465],[-5.7028249,-7.1406769],[-5.5284245,-7.0139263],[-5.3731906,-6.871746],[-5.2444255,-6.7087835],[-5.1165127,-6.5451547],[-4.9885999,-6.3815258],[-4.7476484,-6.5627612],[-4.5001189,-6.7349039],[-4.2463544,-6.8977151],[-3.9867065,-7.0509695],[-4.0889298,-7.2317636],[-4.191153,-7.4125577],[-4.2924345,-7.5938842],[-4.3643864,-7.7917116],[-4.4147486,-8.001342],[-4.4491594,-8.2192197],[-4.4696324,-8.4438358],[-4.4772208,-8.674222],[-4.4725521,-8.9096487],[-4.4560257,-9.1495135],[-4.4279043,-9.3932902],[-4.3883632,-9.6405005],[-4.3375203,-9.8906985],[-4.2354751,-9.9348251],[-4.1329811,-9.977899],[-4.030049,-10.0199154],[-3.92669,-10.06087],[-3.7138219,-9.9199047],[-3.5110581,-9.7730603],[-3.318797,-9.6205691],[-3.1375011,-9.4626449],[-2.967728,-9.2994744],[-2.8101861,-9.1312009],[-2.6658351,-8.9578968],[-2.5361045,-8.7795019],[-2.4234849,-8.5956594],[-2.3344775,-8.4048965],[-2.2778771,-8.2050625],[-2.2223191,-8.0049391],[-2.1667611,-7.8048156],[-1.8747951,-7.8800472],[-1.5802316,-7.9443608],[-1.2834786,-7.9976673],[-0.9849474,-8.039893],[-1.0102024,-8.2460441],[-1.0354575,-8.4521952],[-1.0596387,-8.6584777],[-1.0504084,-8.8687813],[-1.0167149,-9.0817273],[-0.9651282,-9.2961884],[-0.8980859,-9.5115413],[-0.8169316,-9.7272944],[-0.7225244,-9.9430137],[-0.6154637,-10.1582955],[-0.4961936,-10.3727541],[-0.3650591,-10.586015],[-0.2223398,-10.7977111],[-0.1111758,-10.7994278],[-0.0,-10.8],[0.1111758,-10.7994278],[0.2223398,-10.7977111],[0.3650591,-10.586015],[0.4961936,-10.3727541],[0.6154637,-10.1582955],[0.7225244,-9.9430137],[0.8169316,-9.7272944],[0.8980859,-9.5115413],[0.9651282,-9.2961884],[1.0167149,-9.0817273],[1.0504084,-8.8687813],[1.0596387,-8.6584777],[1.0354575,-8.4521952],[1.0102024,-8.2460441],[0.9849474,-8.039893],[1.2834786,-7.9976673],[1.5802316,-7.9443608],[1.8747951,-7.8800472],[2.1667611,-7.8048156],[2.2223191,-8.0049391],[2.2778771,-8.2050625],[2.3344775,-8.4048965],[2.4234849,-8.5956594],[2.5361045,-8.7795019],[2.6658351,-8.9578968],[2.8101861,-9.1312009],[2.967728,-9.2994744],[3.1375011,-9.4626449],[3.318797,-9.6205691],[3.5110581,-9.7730603],[3.7138219,-9.9199047],[3.92669,-10.06087],[4.030049,-10.0199154],[4.1329811,-9.977899],[4.2354751,-9.9348251],[4.3375203,-9.8906985],[4.3883632,-9.6405005],[4.4279043,-9.3932902],[4.4560257,-9.1495135],[4.4725521,-8.9096487],[4.4772208,-8.674222],[4.4696324,-8.4438358],[4.4491594,-8.2192197],[4.4147486,-8.001342],[4.3643864,-7.7917116],[4.2924345,-7.5938842],[4.191153,-7.4125577],[4.0889298,-7.2317636],[3.9867065,-7.0509695],[4.2463544,-6.8977151],[4.5001189,-6.7349039],[4.7476484,-6.5627612],[4.9885999,-6.3815258],[5.1165127,-6.5451547],[5.2444255,-6.7087835],[5.3731906,-6.871746],[5.5284245,-7.0139263],[5.7028249,-7.1406769],[5.8909492,-7.2558465],[6.0906327,-7.360718],[6.300578,-7.4558937],[6.5198705,-7.5416743],[6.7478011,-7.6181982],[6.983783,-7.6855066],[7.2273072,-7.7435788],[7.4779168,-7.7923527],[7.5577354,-7.7149618],[7.6367532,-7.6367532],[7.7149618,-7.5577354],[7.7923527,-7.4779168],[7.7435788,-7.2273072],[7.6855066,-6.983783],[7.6181982,-6.7478011],[7.5416743,-6.5198705],[7.4558937,-6.300578],[7.360718,-6.0906327],[7.2558465,-5.8909492],[7.1406769,-5.7028249],[7.0139263,-5.5284245],[6.871746,-5.3731906],[6.7087835,-5.2444255],[6.5451547,-5.1165127],[6.3815258,-4.9885999],[6.5627612,-4.7476484],[6.7349039,-4.5001189],[6.8977151,-4.2463544],[7.0509695,-3.9867065],[7.2317636,-4.0889298],[7.4125577,-4.191153],[7.5938842,-4.2924345],[7.7917116,-4.3643864],[8.001342,-4.4147486],[8.2192197,-4.4491594],[8.4438358,-4.4696324],[8.674222,-4.4772208],[8.9096487,-4.4725521],[9.1495135,-4.4560257],[9.3932902,-4.4279043],[9.6405005,-4.3883632],[9.8906985,-4.3375203],[9.9348251,-4.2354751],[9.977899,-4.1329811],[10.0199154,-4.030049],[10.06087,-3.92669],[9.9199047,-3.7138219],[9.7730603,-3.5110581],[9.6205691,-3.318797],[9.4626449,-3.1375011],[9.2994744,-2.967728],[9.1312009,-2.8101861],[8.9578968,-2.6658351],[8.7795019,-2.5361045],[8.5956594,-2.4234849],[8.4048965,-2.3344775],[8.2050625,-2.2778771],[8.0049391,-2.2223191],[7.8048156,-2.1667611],[7.8800472,-1.8747951],[7.9443608,-1.5802316],[7.9976673,-1.2834786]]);}
module driven_profile(){polygon(points=[[27.2637651,-1.4060989],[27.4745339,-1.3502306],[27.6854125,-1.2885965],[27.8963475,-1.2214839],[28.1072889,-1.1491241],[28.3181893,-1.0717079],[28.5290027,-0.9893955],[28.7396848,-0.9023233],[28.9501921,-0.8106092],[29.1604821,-0.7143561],[29.3705131,-0.6136546],[29.5802436,-0.5085852],[29.7896328,-0.3992202],[29.9986403,-0.2856244],[29.9996601,-0.1428138],[30.0,0.0],[29.9996601,0.1428138],[29.9986403,0.2856244],[29.7896328,0.3992202],[29.5802436,0.5085852],[29.3705131,0.6136546],[29.1604821,0.7143561],[28.9501921,0.8106092],[28.7396848,0.9023233],[28.5290027,0.9893955],[28.3181893,1.0717079],[28.1072889,1.1491241],[27.8963475,1.2214839],[27.6854125,1.2885965],[27.4745339,1.3502306],[27.2637651,1.4060989],[27.2533171,1.5958408],[27.2415486,1.7855054],[27.2284602,1.9750835],[27.2140525,2.1645659],[27.4157259,2.2474671],[27.6167555,2.3360991],[27.817126,2.4301701],[28.016818,2.5294442],[28.2158092,2.6337261],[28.4140752,2.742851],[28.6115896,2.8566778],[28.8083249,2.975084],[29.0042524,3.097962],[29.1993422,3.2252166],[29.3935642,3.3567623],[29.586887,3.4925226],[29.7792792,3.6324275],[29.7616498,3.7741494],[29.7433458,3.9157858],[29.7243679,4.0573334],[29.7047163,4.1987891],[29.4826696,4.2841321],[29.2607968,4.3652308],[29.0391463,4.4420259],[28.817768,4.5144514],[28.5967135,4.5824327],[28.376036,4.6458854],[28.1557911,4.7047132],[27.9360373,4.7588048],[27.7168364,4.8080306],[27.4982547,4.8522379],[27.2803643,4.8912438],[27.063245,4.9248255],[26.846987,4.952705],[26.8118622,5.1394599],[26.7754382,5.3259658],[26.7377168,5.5122136],[26.6987,5.6981944],[26.8878273,5.80671],[27.0755682,5.9208234],[27.2619458,6.0402432],[27.4469715,6.164733],[27.6306488,6.2940963],[27.8129749,6.4281666],[27.9939422,6.5668004],[28.1735393,6.7098727],[28.3517518,6.8572732],[28.5285626,7.0089034],[28.7039527,7.1646748],[28.8779014,7.3245072],[29.0503864,7.4883275],[29.0144094,7.6265358],[28.9777748,7.7645714],[28.9404835,7.9024309],[28.9025364,8.0401114],[28.6712499,8.0957414],[28.4406897,8.147186],[28.2109116,8.1943929],[27.9819739,8.2373031],[27.7539371,8.2758494],[27.5268653,8.3099552],[27.3008261,8.3395319],[27.075892,8.3644771],[26.8521411,8.3846703],[26.6296592,8.3999688],[26.4085416,8.4102006],[26.1888965,8.4151552],[25.9708496,8.4145689],[25.9116488,8.5951414],[25.8511925,8.7752974],[25.7894837,8.9550282],[25.7265253,9.1343252],[25.8998704,9.2665985],[26.0711105,9.4042408],[26.2403061,9.5469661],[26.4074997,9.6945416],[26.5727204,9.8467728],[26.735987,10.0034944],[26.8973107,10.1645632],[27.0566967,10.3298536],[27.2141448,10.4992544],[27.3696513,10.6726659],[27.5232087,10.8499977],[27.6748069,11.0311676],[27.8244335,11.2161001],[27.7707244,11.3484301],[27.716386,11.480503],[27.6614194,11.6123156],[27.605826,11.7438651],[27.3692571,11.7688303],[27.1339544,11.7897406],[26.8999804,11.8065516],[26.6674004,11.8192123],[26.4362832,11.8276641],[26.2067024,11.8318392],[25.9787364,11.8316589],[25.7524706,11.8270309],[25.5279982,11.8178461],[25.3054228,11.8039739],[25.0848614,11.7852566],[24.8664487,11.7614994],[24.6503438,11.7324572],[24.56808,11.9037576],[24.4846258,12.0744812],[24.3999853,12.2446198],[24.3141626,12.4141652],[24.4687596,12.567933],[24.6205688,12.7267489],[24.7696875,12.8903377],[24.9161883,13.0584738],[25.0601253,13.2309683],[25.2015389,13.4076597],[25.3404588,13.5884075],[25.4769064,13.7730879],[25.6108964,13.9615906],[25.7424377,14.1538161],[25.871535,14.3496741],[25.9981888,14.5490816],[26.1223968,14.7519622],[26.0518746,14.8761497],[25.9807621,15.0],[25.9090608,15.1235104],[25.8367724,15.2466781],[25.5989687,15.2405512],[25.3629498,15.2305695],[25.1287832,15.216697],[24.8965403,15.1988916],[24.6662972,15.1771042],[24.4381355,15.1512773],[24.2121433,15.121343],[23.9884173,15.087221],[23.7670642,15.0488151],[23.5482036,15.0060098],[23.3319723,14.9586635],[23.118529,14.906601],[22.9080637,14.8495999],[22.8041445,15.0086972],[22.6991204,15.1670674],[22.5929965,15.3247026],[22.4857779,15.4815953],[22.6189816,15.6542266],[22.7487623,15.8314989],[22.8752527,16.013152],[22.998554,16.1989719],[23.1187445,16.3887783],[23.2358854,16.5824162],[23.3500245,16.7797504],[23.4611992,16.9806608],[23.5694383,17.18504],[23.6747639,17.3927906],[23.7771921,17.6038235],[23.8767345,17.8180568],[23.9733986,18.0354141],[23.8872701,18.1493341],[23.8006002,18.2628429],[23.713391,18.3759377],[23.6256444,18.4886162],[23.3906748,18.4515021],[23.157978,18.4107991],[22.9276254,18.3664804],[22.6996935,18.3185136],[22.474264,18.2668598],[22.2514253,18.2114728],[22.0312738,18.1522967],[21.8139156,18.0892645],[21.5994691,18.0222948],[21.3880682,17.9512887],[21.1798666,17.8761236],[20.9750449,17.7966465],[20.7738203,17.7126618],[20.6500238,17.8568339],[20.5252267,18.0001408],[20.3994352,18.1425755],[20.2726552,18.2841311],[20.3821864,18.472672],[20.4877182,18.6653676],[20.589416,18.8619769],[20.6874081,19.0623012],[20.7817956,19.2661717],[20.8726596,19.473443],[20.9600649,19.6839871],[21.0440644,19.8976899],[21.1247007,20.1144486],[21.2020083,20.3341697],[21.2760149,20.5567667],[21.3467426,20.7821601],[21.4142089,21.010275],[21.3139477,21.1119785],[21.2132034,21.2132034],[21.1119785,21.3139477],[21.010275,21.4142089],[20.7821601,21.3467426],[20.5567667,21.2760149],[20.3341697,21.2020083],[20.1144486,21.1247007],[19.8976899,21.0440644],[19.6839871,20.9600649],[19.473443,20.8726596],[19.2661717,20.7817956],[19.0623012,20.6874081],[18.8619769,20.589416],[18.6653676,20.4877182],[18.472672,20.3821864],[18.2841311,20.2726552],[18.1425755,20.3994352],[18.0001408,20.5252267],[17.8568339,20.6500238],[17.7126618,20.7738203],[17.7966465,20.9750449],[17.8761236,21.1798666],[17.9512887,21.3880682],[18.0222948,21.5994691],[18.0892645,21.8139156],[18.1522967,22.0312738],[18.2114728,22.2514253],[18.2668598,22.474264],[18.3185136,22.6996935],[18.3664804,22.9276254],[18.4107991,23.157978],[18.4515021,23.3906748],[18.4886162,23.6256444],[18.3759377,23.713391],[18.2628429,23.8006002],[18.1493341,23.8872701],[18.0354141,23.9733986],[17.8180568,23.8767345],[17.6038235,23.7771921],[17.3927906,23.6747639],[17.18504,23.5694383],[16.9806608,23.4611992],[16.7797504,23.3500245],[16.5824162,23.2358854],[16.3887783,23.1187445],[16.1989719,22.998554],[16.013152,22.8752527],[15.8314989,22.7487623],[15.6542266,22.6189816],[15.4815953,22.4857779],[15.3247026,22.5929965],[15.1670674,22.6991204],[15.0086972,22.8041445],[14.8495999,22.9080637],[14.906601,23.118529],[14.9586635,23.3319723],[15.0060098,23.5482036],[15.0488151,23.7670642],[15.087221,23.9884173],[15.121343,24.2121433],[15.1512773,24.4381355],[15.1771042,24.6662972],[15.1988916,24.8965403],[15.216697,25.1287832],[15.2305695,25.3629498],[15.2405512,25.5989687],[15.2466781,25.8367724],[15.1235104,25.9090608],[15.0,25.9807621],[14.8761497,26.0518746],[14.7519622,26.1223968],[14.5490816,25.9981888],[14.3496741,25.871535],[14.1538161,25.7424377],[13.9615906,25.6108964],[13.7730879,25.4769064],[13.5884075,25.3404588],[13.4076597,25.2015389],[13.2309683,25.0601253],[13.0584738,24.9161883],[12.8903377,24.7696875],[12.7267489,24.6205688],[12.567933,24.4687596],[12.4141652,24.3141626],[12.2446198,24.3999853],[12.0744812,24.4846258],[11.9037576,24.56808],[11.7324572,24.6503438],[11.7614994,24.8664487],[11.7852566,25.0848614],[11.8039739,25.3054228],[11.8178461,25.5279982],[11.8270309,25.7524706],[11.8316589,25.9787364],[11.8318392,26.2067024],[11.8276641,26.4362832],[11.8192123,26.6674004],[11.8065516,26.8999804],[11.7897406,27.1339544],[11.7688303,27.3692571],[11.7438651,27.605826],[11.6123156,27.6614194],[11.480503,27.716386],[11.3484301,27.7707244],[11.2161001,27.8244335],[11.0311676,27.6748069],[10.8499977,27.5232087],[10.6726659,27.3696513],[10.4992544,27.2141448],[10.3298536,27.0566967],[10.1645632,26.8973107],[10.0034944,26.735987],[9.8467728,26.5727204],[9.6945416,26.4074997],[9.5469661,26.2403061],[9.4042408,26.0711105],[9.2665985,25.8998704],[9.1343252,25.7265253],[8.9550282,25.7894837],[8.7752974,25.8511925],[8.5951414,25.9116488],[8.4145689,25.9708496],[8.4151552,26.1888965],[8.4102006,26.4085416],[8.3999688,26.6296592],[8.3846703,26.8521411],[8.3644771,27.075892],[8.3395319,27.3008261],[8.3099552,27.5268653],[8.2758494,27.7539371],[8.2373031,27.9819739],[8.1943929,28.2109116],[8.147186,28.4406897],[8.0957414,28.6712499],[8.0401114,28.9025364],[7.9024309,28.9404835],[7.7645714,28.9777748],[7.6265358,29.0144094],[7.4883275,29.0503864],[7.3245072,28.8779014],[7.1646748,28.7039527],[7.0089034,28.5285626],[6.8572732,28.3517518],[6.7098727,28.1735393],[6.5668004,27.9939422],[6.4281666,27.8129749],[6.2940963,27.6306488],[6.164733,27.4469715],[6.0402432,27.2619458],[5.9208234,27.0755682],[5.80671,26.8878273],[5.6981944,26.6987],[5.5122136,26.7377168],[5.3259658,26.7754382],[5.1394599,26.8118622],[4.952705,26.846987],[4.9248255,27.063245],[4.8912438,27.2803643],[4.8522379,27.4982547],[4.8080306,27.7168364],[4.7588048,27.9360373],[4.7047132,28.1557911],[4.6458854,28.376036],[4.5824327,28.5967135],[4.5144514,28.817768],[4.4420259,29.0391463],[4.3652308,29.2607968],[4.2841321,29.4826696],[4.1987891,29.7047163],[4.0573334,29.7243679],[3.9157858,29.7433458],[3.7741494,29.7616498],[3.6324275,29.7792792],[3.4925226,29.586887],[3.3567623,29.3935642],[3.2252166,29.1993422],[3.097962,29.0042524],[2.975084,28.8083249],[2.8566778,28.6115896],[2.742851,28.4140752],[2.6337261,28.2158092],[2.5294442,28.016818],[2.4301701,27.817126],[2.3360991,27.6167555],[2.2474671,27.4157259],[2.1645659,27.2140525],[1.9750835,27.2284602],[1.7855054,27.2415486],[1.5958408,27.2533171],[1.4060989,27.2637651],[1.3502306,27.4745339],[1.2885965,27.6854125],[1.2214839,27.8963475],[1.1491241,28.1072889],[1.0717079,28.3181893],[0.9893955,28.5290027],[0.9023233,28.7396848],[0.8106092,28.9501921],[0.7143561,29.1604821],[0.6136546,29.3705131],[0.5085852,29.5802436],[0.3992202,29.7896328],[0.2856244,29.9986403],[0.1428138,29.9996601],[0.0,30.0],[-0.1428138,29.9996601],[-0.2856244,29.9986403],[-0.3992202,29.7896328],[-0.5085852,29.5802436],[-0.6136546,29.3705131],[-0.7143561,29.1604821],[-0.8106092,28.9501921],[-0.9023233,28.7396848],[-0.9893955,28.5290027],[-1.0717079,28.3181893],[-1.1491241,28.1072889],[-1.2214839,27.8963475],[-1.2885965,27.6854125],[-1.3502306,27.4745339],[-1.4060989,27.2637651],[-1.5958408,27.2533171],[-1.7855054,27.2415486],[-1.9750835,27.2284602],[-2.1645659,27.2140525],[-2.2474671,27.4157259],[-2.3360991,27.6167555],[-2.4301701,27.817126],[-2.5294442,28.016818],[-2.6337261,28.2158092],[-2.742851,28.4140752],[-2.8566778,28.6115896],[-2.975084,28.8083249],[-3.097962,29.0042524],[-3.2252166,29.1993422],[-3.3567623,29.3935642],[-3.4925226,29.586887],[-3.6324275,29.7792792],[-3.7741494,29.7616498],[-3.9157858,29.7433458],[-4.0573334,29.7243679],[-4.1987891,29.7047163],[-4.2841321,29.4826696],[-4.3652308,29.2607968],[-4.4420259,29.0391463],[-4.5144514,28.817768],[-4.5824327,28.5967135],[-4.6458854,28.376036],[-4.7047132,28.1557911],[-4.7588048,27.9360373],[-4.8080306,27.7168364],[-4.8522379,27.4982547],[-4.8912438,27.2803643],[-4.9248255,27.063245],[-4.952705,26.846987],[-5.1394599,26.8118622],[-5.3259658,26.7754382],[-5.5122136,26.7377168],[-5.6981944,26.6987],[-5.80671,26.8878273],[-5.9208234,27.0755682],[-6.0402432,27.2619458],[-6.164733,27.4469715],[-6.2940963,27.6306488],[-6.4281666,27.8129749],[-6.5668004,27.9939422],[-6.7098727,28.1735393],[-6.8572732,28.3517518],[-7.0089034,28.5285626],[-7.1646748,28.7039527],[-7.3245072,28.8779014],[-7.4883275,29.0503864],[-7.6265358,29.0144094],[-7.7645714,28.9777748],[-7.9024309,28.9404835],[-8.0401114,28.9025364],[-8.0957414,28.6712499],[-8.147186,28.4406897],[-8.1943929,28.2109116],[-8.2373031,27.9819739],[-8.2758494,27.7539371],[-8.3099552,27.5268653],[-8.3395319,27.3008261],[-8.3644771,27.075892],[-8.3846703,26.8521411],[-8.3999688,26.6296592],[-8.4102006,26.4085416],[-8.4151552,26.1888965],[-8.4145689,25.9708496],[-8.5951414,25.9116488],[-8.7752974,25.8511925],[-8.9550282,25.7894837],[-9.1343252,25.7265253],[-9.2665985,25.8998704],[-9.4042408,26.0711105],[-9.5469661,26.2403061],[-9.6945416,26.4074997],[-9.8467728,26.5727204],[-10.0034944,26.735987],[-10.1645632,26.8973107],[-10.3298536,27.0566967],[-10.4992544,27.2141448],[-10.6726659,27.3696513],[-10.8499977,27.5232087],[-11.0311676,27.6748069],[-11.2161001,27.8244335],[-11.3484301,27.7707244],[-11.480503,27.716386],[-11.6123156,27.6614194],[-11.7438651,27.605826],[-11.7688303,27.3692571],[-11.7897406,27.1339544],[-11.8065516,26.8999804],[-11.8192123,26.6674004],[-11.8276641,26.4362832],[-11.8318392,26.2067024],[-11.8316589,25.9787364],[-11.8270309,25.7524706],[-11.8178461,25.5279982],[-11.8039739,25.3054228],[-11.7852566,25.0848614],[-11.7614994,24.8664487],[-11.7324572,24.6503438],[-11.9037576,24.56808],[-12.0744812,24.4846258],[-12.2446198,24.3999853],[-12.4141652,24.3141626],[-12.567933,24.4687596],[-12.7267489,24.6205688],[-12.8903377,24.7696875],[-13.0584738,24.9161883],[-13.2309683,25.0601253],[-13.4076597,25.2015389],[-13.5884075,25.3404588],[-13.7730879,25.4769064],[-13.9615906,25.6108964],[-14.1538161,25.7424377],[-14.3496741,25.871535],[-14.5490816,25.9981888],[-14.7519622,26.1223968],[-14.8761497,26.0518746],[-15.0,25.9807621],[-15.1235104,25.9090608],[-15.2466781,25.8367724],[-15.2405512,25.5989687],[-15.2305695,25.3629498],[-15.216697,25.1287832],[-15.1988916,24.8965403],[-15.1771042,24.6662972],[-15.1512773,24.4381355],[-15.121343,24.2121433],[-15.087221,23.9884173],[-15.0488151,23.7670642],[-15.0060098,23.5482036],[-14.9586635,23.3319723],[-14.906601,23.118529],[-14.8495999,22.9080637],[-15.0086972,22.8041445],[-15.1670674,22.6991204],[-15.3247026,22.5929965],[-15.4815953,22.4857779],[-15.6542266,22.6189816],[-15.8314989,22.7487623],[-16.013152,22.8752527],[-16.1989719,22.998554],[-16.3887783,23.1187445],[-16.5824162,23.2358854],[-16.7797504,23.3500245],[-16.9806608,23.4611992],[-17.18504,23.5694383],[-17.3927906,23.6747639],[-17.6038235,23.7771921],[-17.8180568,23.8767345],[-18.0354141,23.9733986],[-18.1493341,23.8872701],[-18.2628429,23.8006002],[-18.3759377,23.713391],[-18.4886162,23.6256444],[-18.4515021,23.3906748],[-18.4107991,23.157978],[-18.3664804,22.9276254],[-18.3185136,22.6996935],[-18.2668598,22.474264],[-18.2114728,22.2514253],[-18.1522967,22.0312738],[-18.0892645,21.8139156],[-18.0222948,21.5994691],[-17.9512887,21.3880682],[-17.8761236,21.1798666],[-17.7966465,20.9750449],[-17.7126618,20.7738203],[-17.8568339,20.6500238],[-18.0001408,20.5252267],[-18.1425755,20.3994352],[-18.2841311,20.2726552],[-18.472672,20.3821864],[-18.6653676,20.4877182],[-18.8619769,20.589416],[-19.0623012,20.6874081],[-19.2661717,20.7817956],[-19.473443,20.8726596],[-19.6839871,20.9600649],[-19.8976899,21.0440644],[-20.1144486,21.1247007],[-20.3341697,21.2020083],[-20.5567667,21.2760149],[-20.7821601,21.3467426],[-21.010275,21.4142089],[-21.1119785,21.3139477],[-21.2132034,21.2132034],[-21.3139477,21.1119785],[-21.4142089,21.010275],[-21.3467426,20.7821601],[-21.2760149,20.5567667],[-21.2020083,20.3341697],[-21.1247007,20.1144486],[-21.0440644,19.8976899],[-20.9600649,19.6839871],[-20.8726596,19.473443],[-20.7817956,19.2661717],[-20.6874081,19.0623012],[-20.589416,18.8619769],[-20.4877182,18.6653676],[-20.3821864,18.472672],[-20.2726552,18.2841311],[-20.3994352,18.1425755],[-20.5252267,18.0001408],[-20.6500238,17.8568339],[-20.7738203,17.7126618],[-20.9750449,17.7966465],[-21.1798666,17.8761236],[-21.3880682,17.9512887],[-21.5994691,18.0222948],[-21.8139156,18.0892645],[-22.0312738,18.1522967],[-22.2514253,18.2114728],[-22.474264,18.2668598],[-22.6996935,18.3185136],[-22.9276254,18.3664804],[-23.157978,18.4107991],[-23.3906748,18.4515021],[-23.6256444,18.4886162],[-23.713391,18.3759377],[-23.8006002,18.2628429],[-23.8872701,18.1493341],[-23.9733986,18.0354141],[-23.8767345,17.8180568],[-23.7771921,17.6038235],[-23.6747639,17.3927906],[-23.5694383,17.18504],[-23.4611992,16.9806608],[-23.3500245,16.7797504],[-23.2358854,16.5824162],[-23.1187445,16.3887783],[-22.998554,16.1989719],[-22.8752527,16.013152],[-22.7487623,15.8314989],[-22.6189816,15.6542266],[-22.4857779,15.4815953],[-22.5929965,15.3247026],[-22.6991204,15.1670674],[-22.8041445,15.0086972],[-22.9080637,14.8495999],[-23.118529,14.906601],[-23.3319723,14.9586635],[-23.5482036,15.0060098],[-23.7670642,15.0488151],[-23.9884173,15.087221],[-24.2121433,15.121343],[-24.4381355,15.1512773],[-24.6662972,15.1771042],[-24.8965403,15.1988916],[-25.1287832,15.216697],[-25.3629498,15.2305695],[-25.5989687,15.2405512],[-25.8367724,15.2466781],[-25.9090608,15.1235104],[-25.9807621,15.0],[-26.0518746,14.8761497],[-26.1223968,14.7519622],[-25.9981888,14.5490816],[-25.871535,14.3496741],[-25.7424377,14.1538161],[-25.6108964,13.9615906],[-25.4769064,13.7730879],[-25.3404588,13.5884075],[-25.2015389,13.4076597],[-25.0601253,13.2309683],[-24.9161883,13.0584738],[-24.7696875,12.8903377],[-24.6205688,12.7267489],[-24.4687596,12.567933],[-24.3141626,12.4141652],[-24.3999853,12.2446198],[-24.4846258,12.0744812],[-24.56808,11.9037576],[-24.6503438,11.7324572],[-24.8664487,11.7614994],[-25.0848614,11.7852566],[-25.3054228,11.8039739],[-25.5279982,11.8178461],[-25.7524706,11.8270309],[-25.9787364,11.8316589],[-26.2067024,11.8318392],[-26.4362832,11.8276641],[-26.6674004,11.8192123],[-26.8999804,11.8065516],[-27.1339544,11.7897406],[-27.3692571,11.7688303],[-27.605826,11.7438651],[-27.6614194,11.6123156],[-27.716386,11.480503],[-27.7707244,11.3484301],[-27.8244335,11.2161001],[-27.6748069,11.0311676],[-27.5232087,10.8499977],[-27.3696513,10.6726659],[-27.2141448,10.4992544],[-27.0566967,10.3298536],[-26.8973107,10.1645632],[-26.735987,10.0034944],[-26.5727204,9.8467728],[-26.4074997,9.6945416],[-26.2403061,9.5469661],[-26.0711105,9.4042408],[-25.8998704,9.2665985],[-25.7265253,9.1343252],[-25.7894837,8.9550282],[-25.8511925,8.7752974],[-25.9116488,8.5951414],[-25.9708496,8.4145689],[-26.1888965,8.4151552],[-26.4085416,8.4102006],[-26.6296592,8.3999688],[-26.8521411,8.3846703],[-27.075892,8.3644771],[-27.3008261,8.3395319],[-27.5268653,8.3099552],[-27.7539371,8.2758494],[-27.9819739,8.2373031],[-28.2109116,8.1943929],[-28.4406897,8.147186],[-28.6712499,8.0957414],[-28.9025364,8.0401114],[-28.9404835,7.9024309],[-28.9777748,7.7645714],[-29.0144094,7.6265358],[-29.0503864,7.4883275],[-28.8779014,7.3245072],[-28.7039527,7.1646748],[-28.5285626,7.0089034],[-28.3517518,6.8572732],[-28.1735393,6.7098727],[-27.9939422,6.5668004],[-27.8129749,6.4281666],[-27.6306488,6.2940963],[-27.4469715,6.164733],[-27.2619458,6.0402432],[-27.0755682,5.9208234],[-26.8878273,5.80671],[-26.6987,5.6981944],[-26.7377168,5.5122136],[-26.7754382,5.3259658],[-26.8118622,5.1394599],[-26.846987,4.952705],[-27.063245,4.9248255],[-27.2803643,4.8912438],[-27.4982547,4.8522379],[-27.7168364,4.8080306],[-27.9360373,4.7588048],[-28.1557911,4.7047132],[-28.376036,4.6458854],[-28.5967135,4.5824327],[-28.817768,4.5144514],[-29.0391463,4.4420259],[-29.2607968,4.3652308],[-29.4826696,4.2841321],[-29.7047163,4.1987891],[-29.7243679,4.0573334],[-29.7433458,3.9157858],[-29.7616498,3.7741494],[-29.7792792,3.6324275],[-29.586887,3.4925226],[-29.3935642,3.3567623],[-29.1993422,3.2252166],[-29.0042524,3.097962],[-28.8083249,2.975084],[-28.6115896,2.8566778],[-28.4140752,2.742851],[-28.2158092,2.6337261],[-28.016818,2.5294442],[-27.817126,2.4301701],[-27.6167555,2.3360991],[-27.4157259,2.2474671],[-27.2140525,2.1645659],[-27.2284602,1.9750835],[-27.2415486,1.7855054],[-27.2533171,1.5958408],[-27.2637651,1.4060989],[-27.4745339,1.3502306],[-27.6854125,1.2885965],[-27.8963475,1.2214839],[-28.1072889,1.1491241],[-28.3181893,1.0717079],[-28.5290027,0.9893955],[-28.7396848,0.9023233],[-28.9501921,0.8106092],[-29.1604821,0.7143561],[-29.3705131,0.6136546],[-29.5802436,0.5085852],[-29.7896328,0.3992202],[-29.9986403,0.2856244],[-29.9996601,0.1428138],[-30.0,0.0],[-29.9996601,-0.1428138],[-29.9986403,-0.2856244],[-29.7896328,-0.3992202],[-29.5802436,-0.5085852],[-29.3705131,-0.6136546],[-29.1604821,-0.7143561],[-28.9501921,-0.8106092],[-28.7396848,-0.9023233],[-28.5290027,-0.9893955],[-28.3181893,-1.0717079],[-28.1072889,-1.1491241],[-27.8963475,-1.2214839],[-27.6854125,-1.2885965],[-27.4745339,-1.3502306],[-27.2637651,-1.4060989],[-27.2533171,-1.5958408],[-27.2415486,-1.7855054],[-27.2284602,-1.9750835],[-27.2140525,-2.1645659],[-27.4157259,-2.2474671],[-27.6167555,-2.3360991],[-27.817126,-2.4301701],[-28.016818,-2.5294442],[-28.2158092,-2.6337261],[-28.4140752,-2.742851],[-28.6115896,-2.8566778],[-28.8083249,-2.975084],[-29.0042524,-3.097962],[-29.1993422,-3.2252166],[-29.3935642,-3.3567623],[-29.586887,-3.4925226],[-29.7792792,-3.6324275],[-29.7616498,-3.7741494],[-29.7433458,-3.9157858],[-29.7243679,-4.0573334],[-29.7047163,-4.1987891],[-29.4826696,-4.2841321],[-29.2607968,-4.3652308],[-29.0391463,-4.4420259],[-28.817768,-4.5144514],[-28.5967135,-4.5824327],[-28.376036,-4.6458854],[-28.1557911,-4.7047132],[-27.9360373,-4.7588048],[-27.7168364,-4.8080306],[-27.4982547,-4.8522379],[-27.2803643,-4.8912438],[-27.063245,-4.9248255],[-26.846987,-4.952705],[-26.8118622,-5.1394599],[-26.7754382,-5.3259658],[-26.7377168,-5.5122136],[-26.6987,-5.6981944],[-26.8878273,-5.80671],[-27.0755682,-5.9208234],[-27.2619458,-6.0402432],[-27.4469715,-6.164733],[-27.6306488,-6.2940963],[-27.8129749,-6.4281666],[-27.9939422,-6.5668004],[-28.1735393,-6.7098727],[-28.3517518,-6.8572732],[-28.5285626,-7.0089034],[-28.7039527,-7.1646748],[-28.8779014,-7.3245072],[-29.0503864,-7.4883275],[-29.0144094,-7.6265358],[-28.9777748,-7.7645714],[-28.9404835,-7.9024309],[-28.9025364,-8.0401114],[-28.6712499,-8.0957414],[-28.4406897,-8.147186],[-28.2109116,-8.1943929],[-27.9819739,-8.2373031],[-27.7539371,-8.2758494],[-27.5268653,-8.3099552],[-27.3008261,-8.3395319],[-27.075892,-8.3644771],[-26.8521411,-8.3846703],[-26.6296592,-8.3999688],[-26.4085416,-8.4102006],[-26.1888965,-8.4151552],[-25.9708496,-8.4145689],[-25.9116488,-8.5951414],[-25.8511925,-8.7752974],[-25.7894837,-8.9550282],[-25.7265253,-9.1343252],[-25.8998704,-9.2665985],[-26.0711105,-9.4042408],[-26.2403061,-9.5469661],[-26.4074997,-9.6945416],[-26.5727204,-9.8467728],[-26.735987,-10.0034944],[-26.8973107,-10.1645632],[-27.0566967,-10.3298536],[-27.2141448,-10.4992544],[-27.3696513,-10.6726659],[-27.5232087,-10.8499977],[-27.6748069,-11.0311676],[-27.8244335,-11.2161001],[-27.7707244,-11.3484301],[-27.716386,-11.480503],[-27.6614194,-11.6123156],[-27.605826,-11.7438651],[-27.3692571,-11.7688303],[-27.1339544,-11.7897406],[-26.8999804,-11.8065516],[-26.6674004,-11.8192123],[-26.4362832,-11.8276641],[-26.2067024,-11.8318392],[-25.9787364,-11.8316589],[-25.7524706,-11.8270309],[-25.5279982,-11.8178461],[-25.3054228,-11.8039739],[-25.0848614,-11.7852566],[-24.8664487,-11.7614994],[-24.6503438,-11.7324572],[-24.56808,-11.9037576],[-24.4846258,-12.0744812],[-24.3999853,-12.2446198],[-24.3141626,-12.4141652],[-24.4687596,-12.567933],[-24.6205688,-12.7267489],[-24.7696875,-12.8903377],[-24.9161883,-13.0584738],[-25.0601253,-13.2309683],[-25.2015389,-13.4076597],[-25.3404588,-13.5884075],[-25.4769064,-13.7730879],[-25.6108964,-13.9615906],[-25.7424377,-14.1538161],[-25.871535,-14.3496741],[-25.9981888,-14.5490816],[-26.1223968,-14.7519622],[-26.0518746,-14.8761497],[-25.9807621,-15.0],[-25.9090608,-15.1235104],[-25.8367724,-15.2466781],[-25.5989687,-15.2405512],[-25.3629498,-15.2305695],[-25.1287832,-15.216697],[-24.8965403,-15.1988916],[-24.6662972,-15.1771042],[-24.4381355,-15.1512773],[-24.2121433,-15.121343],[-23.9884173,-15.087221],[-23.7670642,-15.0488151],[-23.5482036,-15.0060098],[-23.3319723,-14.9586635],[-23.118529,-14.906601],[-22.9080637,-14.8495999],[-22.8041445,-15.0086972],[-22.6991204,-15.1670674],[-22.5929965,-15.3247026],[-22.4857779,-15.4815953],[-22.6189816,-15.6542266],[-22.7487623,-15.8314989],[-22.8752527,-16.013152],[-22.998554,-16.1989719],[-23.1187445,-16.3887783],[-23.2358854,-16.5824162],[-23.3500245,-16.7797504],[-23.4611992,-16.9806608],[-23.5694383,-17.18504],[-23.6747639,-17.3927906],[-23.7771921,-17.6038235],[-23.8767345,-17.8180568],[-23.9733986,-18.0354141],[-23.8872701,-18.1493341],[-23.8006002,-18.2628429],[-23.713391,-18.3759377],[-23.6256444,-18.4886162],[-23.3906748,-18.4515021],[-23.157978,-18.4107991],[-22.9276254,-18.3664804],[-22.6996935,-18.3185136],[-22.474264,-18.2668598],[-22.2514253,-18.2114728],[-22.0312738,-18.1522967],[-21.8139156,-18.0892645],[-21.5994691,-18.0222948],[-21.3880682,-17.9512887],[-21.1798666,-17.8761236],[-20.9750449,-17.7966465],[-20.7738203,-17.7126618],[-20.6500238,-17.8568339],[-20.5252267,-18.0001408],[-20.3994352,-18.1425755],[-20.2726552,-18.2841311],[-20.3821864,-18.472672],[-20.4877182,-18.6653676],[-20.589416,-18.8619769],[-20.6874081,-19.0623012],[-20.7817956,-19.2661717],[-20.8726596,-19.473443],[-20.9600649,-19.6839871],[-21.0440644,-19.8976899],[-21.1247007,-20.1144486],[-21.2020083,-20.3341697],[-21.2760149,-20.5567667],[-21.3467426,-20.7821601],[-21.4142089,-21.010275],[-21.3139477,-21.1119785],[-21.2132034,-21.2132034],[-21.1119785,-21.3139477],[-21.010275,-21.4142089],[-20.7821601,-21.3467426],[-20.5567667,-21.2760149],[-20.3341697,-21.2020083],[-20.1144486,-21.1247007],[-19.8976899,-21.0440644],[-19.6839871,-20.9600649],[-19.473443,-20.8726596],[-19.2661717,-20.7817956],[-19.0623012,-20.6874081],[-18.8619769,-20.589416],[-18.6653676,-20.4877182],[-18.472672,-20.3821864],[-18.2841311,-20.2726552],[-18.1425755,-20.3994352],[-18.0001408,-20.5252267],[-17.8568339,-20.6500238],[-17.7126618,-20.7738203],[-17.7966465,-20.9750449],[-17.8761236,-21.1798666],[-17.9512887,-21.3880682],[-18.0222948,-21.5994691],[-18.0892645,-21.8139156],[-18.1522967,-22.0312738],[-18.2114728,-22.2514253],[-18.2668598,-22.474264],[-18.3185136,-22.6996935],[-18.3664804,-22.9276254],[-18.4107991,-23.157978],[-18.4515021,-23.3906748],[-18.4886162,-23.6256444],[-18.3759377,-23.713391],[-18.2628429,-23.8006002],[-18.1493341,-23.8872701],[-18.0354141,-23.9733986],[-17.8180568,-23.8767345],[-17.6038235,-23.7771921],[-17.3927906,-23.6747639],[-17.18504,-23.5694383],[-16.9806608,-23.4611992],[-16.7797504,-23.3500245],[-16.5824162,-23.2358854],[-16.3887783,-23.1187445],[-16.1989719,-22.998554],[-16.013152,-22.8752527],[-15.8314989,-22.7487623],[-15.6542266,-22.6189816],[-15.4815953,-22.4857779],[-15.3247026,-22.5929965],[-15.1670674,-22.6991204],[-15.0086972,-22.8041445],[-14.8495999,-22.9080637],[-14.906601,-23.118529],[-14.9586635,-23.3319723],[-15.0060098,-23.5482036],[-15.0488151,-23.7670642],[-15.087221,-23.9884173],[-15.121343,-24.2121433],[-15.1512773,-24.4381355],[-15.1771042,-24.6662972],[-15.1988916,-24.8965403],[-15.216697,-25.1287832],[-15.2305695,-25.3629498],[-15.2405512,-25.5989687],[-15.2466781,-25.8367724],[-15.1235104,-25.9090608],[-15.0,-25.9807621],[-14.8761497,-26.0518746],[-14.7519622,-26.1223968],[-14.5490816,-25.9981888],[-14.3496741,-25.871535],[-14.1538161,-25.7424377],[-13.9615906,-25.6108964],[-13.7730879,-25.4769064],[-13.5884075,-25.3404588],[-13.4076597,-25.2015389],[-13.2309683,-25.0601253],[-13.0584738,-24.9161883],[-12.8903377,-24.7696875],[-12.7267489,-24.6205688],[-12.567933,-24.4687596],[-12.4141652,-24.3141626],[-12.2446198,-24.3999853],[-12.0744812,-24.4846258],[-11.9037576,-24.56808],[-11.7324572,-24.6503438],[-11.7614994,-24.8664487],[-11.7852566,-25.0848614],[-11.8039739,-25.3054228],[-11.8178461,-25.5279982],[-11.8270309,-25.7524706],[-11.8316589,-25.9787364],[-11.8318392,-26.2067024],[-11.8276641,-26.4362832],[-11.8192123,-26.6674004],[-11.8065516,-26.8999804],[-11.7897406,-27.1339544],[-11.7688303,-27.3692571],[-11.7438651,-27.605826],[-11.6123156,-27.6614194],[-11.480503,-27.716386],[-11.3484301,-27.7707244],[-11.2161001,-27.8244335],[-11.0311676,-27.6748069],[-10.8499977,-27.5232087],[-10.6726659,-27.3696513],[-10.4992544,-27.2141448],[-10.3298536,-27.0566967],[-10.1645632,-26.8973107],[-10.0034944,-26.735987],[-9.8467728,-26.5727204],[-9.6945416,-26.4074997],[-9.5469661,-26.2403061],[-9.4042408,-26.0711105],[-9.2665985,-25.8998704],[-9.1343252,-25.7265253],[-8.9550282,-25.7894837],[-8.7752974,-25.8511925],[-8.5951414,-25.9116488],[-8.4145689,-25.9708496],[-8.4151552,-26.1888965],[-8.4102006,-26.4085416],[-8.3999688,-26.6296592],[-8.3846703,-26.8521411],[-8.3644771,-27.075892],[-8.3395319,-27.3008261],[-8.3099552,-27.5268653],[-8.2758494,-27.7539371],[-8.2373031,-27.9819739],[-8.1943929,-28.2109116],[-8.147186,-28.4406897],[-8.0957414,-28.6712499],[-8.0401114,-28.9025364],[-7.9024309,-28.9404835],[-7.7645714,-28.9777748],[-7.6265358,-29.0144094],[-7.4883275,-29.0503864],[-7.3245072,-28.8779014],[-7.1646748,-28.7039527],[-7.0089034,-28.5285626],[-6.8572732,-28.3517518],[-6.7098727,-28.1735393],[-6.5668004,-27.9939422],[-6.4281666,-27.8129749],[-6.2940963,-27.6306488],[-6.164733,-27.4469715],[-6.0402432,-27.2619458],[-5.9208234,-27.0755682],[-5.80671,-26.8878273],[-5.6981944,-26.6987],[-5.5122136,-26.7377168],[-5.3259658,-26.7754382],[-5.1394599,-26.8118622],[-4.952705,-26.846987],[-4.9248255,-27.063245],[-4.8912438,-27.2803643],[-4.8522379,-27.4982547],[-4.8080306,-27.7168364],[-4.7588048,-27.9360373],[-4.7047132,-28.1557911],[-4.6458854,-28.376036],[-4.5824327,-28.5967135],[-4.5144514,-28.817768],[-4.4420259,-29.0391463],[-4.3652308,-29.2607968],[-4.2841321,-29.4826696],[-4.1987891,-29.7047163],[-4.0573334,-29.7243679],[-3.9157858,-29.7433458],[-3.7741494,-29.7616498],[-3.6324275,-29.7792792],[-3.4925226,-29.586887],[-3.3567623,-29.3935642],[-3.2252166,-29.1993422],[-3.097962,-29.0042524],[-2.975084,-28.8083249],[-2.8566778,-28.6115896],[-2.742851,-28.4140752],[-2.6337261,-28.2158092],[-2.5294442,-28.016818],[-2.4301701,-27.817126],[-2.3360991,-27.6167555],[-2.2474671,-27.4157259],[-2.1645659,-27.2140525],[-1.9750835,-27.2284602],[-1.7855054,-27.2415486],[-1.5958408,-27.2533171],[-1.4060989,-27.2637651],[-1.3502306,-27.4745339],[-1.2885965,-27.6854125],[-1.2214839,-27.8963475],[-1.1491241,-28.1072889],[-1.0717079,-28.3181893],[-0.9893955,-28.5290027],[-0.9023233,-28.7396848],[-0.8106092,-28.9501921],[-0.7143561,-29.1604821],[-0.6136546,-29.3705131],[-0.5085852,-29.5802436],[-0.3992202,-29.7896328],[-0.2856244,-29.9986403],[-0.1428138,-29.9996601],[-0.0,-30.0],[0.1428138,-29.9996601],[0.2856244,-29.9986403],[0.3992202,-29.7896328],[0.5085852,-29.5802436],[0.6136546,-29.3705131],[0.7143561,-29.1604821],[0.8106092,-28.9501921],[0.9023233,-28.7396848],[0.9893955,-28.5290027],[1.0717079,-28.3181893],[1.1491241,-28.1072889],[1.2214839,-27.8963475],[1.2885965,-27.6854125],[1.3502306,-27.4745339],[1.4060989,-27.2637651],[1.5958408,-27.2533171],[1.7855054,-27.2415486],[1.9750835,-27.2284602],[2.1645659,-27.2140525],[2.2474671,-27.4157259],[2.3360991,-27.6167555],[2.4301701,-27.817126],[2.5294442,-28.016818],[2.6337261,-28.2158092],[2.742851,-28.4140752],[2.8566778,-28.6115896],[2.975084,-28.8083249],[3.097962,-29.0042524],[3.2252166,-29.1993422],[3.3567623,-29.3935642],[3.4925226,-29.586887],[3.6324275,-29.7792792],[3.7741494,-29.7616498],[3.9157858,-29.7433458],[4.0573334,-29.7243679],[4.1987891,-29.7047163],[4.2841321,-29.4826696],[4.3652308,-29.2607968],[4.4420259,-29.0391463],[4.5144514,-28.817768],[4.5824327,-28.5967135],[4.6458854,-28.376036],[4.7047132,-28.1557911],[4.7588048,-27.9360373],[4.8080306,-27.7168364],[4.8522379,-27.4982547],[4.8912438,-27.2803643],[4.9248255,-27.063245],[4.952705,-26.846987],[5.1394599,-26.8118622],[5.3259658,-26.7754382],[5.5122136,-26.7377168],[5.6981944,-26.6987],[5.80671,-26.8878273],[5.9208234,-27.0755682],[6.0402432,-27.2619458],[6.164733,-27.4469715],[6.2940963,-27.6306488],[6.4281666,-27.8129749],[6.5668004,-27.9939422],[6.7098727,-28.1735393],[6.8572732,-28.3517518],[7.0089034,-28.5285626],[7.1646748,-28.7039527],[7.3245072,-28.8779014],[7.4883275,-29.0503864],[7.6265358,-29.0144094],[7.7645714,-28.9777748],[7.9024309,-28.9404835],[8.0401114,-28.9025364],[8.0957414,-28.6712499],[8.147186,-28.4406897],[8.1943929,-28.2109116],[8.2373031,-27.9819739],[8.2758494,-27.7539371],[8.3099552,-27.5268653],[8.3395319,-27.3008261],[8.3644771,-27.075892],[8.3846703,-26.8521411],[8.3999688,-26.6296592],[8.4102006,-26.4085416],[8.4151552,-26.1888965],[8.4145689,-25.9708496],[8.5951414,-25.9116488],[8.7752974,-25.8511925],[8.9550282,-25.7894837],[9.1343252,-25.7265253],[9.2665985,-25.8998704],[9.4042408,-26.0711105],[9.5469661,-26.2403061],[9.6945416,-26.4074997],[9.8467728,-26.5727204],[10.0034944,-26.735987],[10.1645632,-26.8973107],[10.3298536,-27.0566967],[10.4992544,-27.2141448],[10.6726659,-27.3696513],[10.8499977,-27.5232087],[11.0311676,-27.6748069],[11.2161001,-27.8244335],[11.3484301,-27.7707244],[11.480503,-27.716386],[11.6123156,-27.6614194],[11.7438651,-27.605826],[11.7688303,-27.3692571],[11.7897406,-27.1339544],[11.8065516,-26.8999804],[11.8192123,-26.6674004],[11.8276641,-26.4362832],[11.8318392,-26.2067024],[11.8316589,-25.9787364],[11.8270309,-25.7524706],[11.8178461,-25.5279982],[11.8039739,-25.3054228],[11.7852566,-25.0848614],[11.7614994,-24.8664487],[11.7324572,-24.6503438],[11.9037576,-24.56808],[12.0744812,-24.4846258],[12.2446198,-24.3999853],[12.4141652,-24.3141626],[12.567933,-24.4687596],[12.7267489,-24.6205688],[12.8903377,-24.7696875],[13.0584738,-24.9161883],[13.2309683,-25.0601253],[13.4076597,-25.2015389],[13.5884075,-25.3404588],[13.7730879,-25.4769064],[13.9615906,-25.6108964],[14.1538161,-25.7424377],[14.3496741,-25.871535],[14.5490816,-25.9981888],[14.7519622,-26.1223968],[14.8761497,-26.0518746],[15.0,-25.9807621],[15.1235104,-25.9090608],[15.2466781,-25.8367724],[15.2405512,-25.5989687],[15.2305695,-25.3629498],[15.216697,-25.1287832],[15.1988916,-24.8965403],[15.1771042,-24.6662972],[15.1512773,-24.4381355],[15.121343,-24.2121433],[15.087221,-23.9884173],[15.0488151,-23.7670642],[15.0060098,-23.5482036],[14.9586635,-23.3319723],[14.906601,-23.118529],[14.8495999,-22.9080637],[15.0086972,-22.8041445],[15.1670674,-22.6991204],[15.3247026,-22.5929965],[15.4815953,-22.4857779],[15.6542266,-22.6189816],[15.8314989,-22.7487623],[16.013152,-22.8752527],[16.1989719,-22.998554],[16.3887783,-23.1187445],[16.5824162,-23.2358854],[16.7797504,-23.3500245],[16.9806608,-23.4611992],[17.18504,-23.5694383],[17.3927906,-23.6747639],[17.6038235,-23.7771921],[17.8180568,-23.8767345],[18.0354141,-23.9733986],[18.1493341,-23.8872701],[18.2628429,-23.8006002],[18.3759377,-23.713391],[18.4886162,-23.6256444],[18.4515021,-23.3906748],[18.4107991,-23.157978],[18.3664804,-22.9276254],[18.3185136,-22.6996935],[18.2668598,-22.474264],[18.2114728,-22.2514253],[18.1522967,-22.0312738],[18.0892645,-21.8139156],[18.0222948,-21.5994691],[17.9512887,-21.3880682],[17.8761236,-21.1798666],[17.7966465,-20.9750449],[17.7126618,-20.7738203],[17.8568339,-20.6500238],[18.0001408,-20.5252267],[18.1425755,-20.3994352],[18.2841311,-20.2726552],[18.472672,-20.3821864],[18.6653676,-20.4877182],[18.8619769,-20.589416],[19.0623012,-20.6874081],[19.2661717,-20.7817956],[19.473443,-20.8726596],[19.6839871,-20.9600649],[19.8976899,-21.0440644],[20.1144486,-21.1247007],[20.3341697,-21.2020083],[20.5567667,-21.2760149],[20.7821601,-21.3467426],[21.010275,-21.4142089],[21.1119785,-21.3139477],[21.2132034,-21.2132034],[21.3139477,-21.1119785],[21.4142089,-21.010275],[21.3467426,-20.7821601],[21.2760149,-20.5567667],[21.2020083,-20.3341697],[21.1247007,-20.1144486],[21.0440644,-19.8976899],[20.9600649,-19.6839871],[20.8726596,-19.473443],[20.7817956,-19.2661717],[20.6874081,-19.0623012],[20.589416,-18.8619769],[20.4877182,-18.6653676],[20.3821864,-18.472672],[20.2726552,-18.2841311],[20.3994352,-18.1425755],[20.5252267,-18.0001408],[20.6500238,-17.8568339],[20.7738203,-17.7126618],[20.9750449,-17.7966465],[21.1798666,-17.8761236],[21.3880682,-17.9512887],[21.5994691,-18.0222948],[21.8139156,-18.0892645],[22.0312738,-18.1522967],[22.2514253,-18.2114728],[22.474264,-18.2668598],[22.6996935,-18.3185136],[22.9276254,-18.3664804],[23.157978,-18.4107991],[23.3906748,-18.4515021],[23.6256444,-18.4886162],[23.713391,-18.3759377],[23.8006002,-18.2628429],[23.8872701,-18.1493341],[23.9733986,-18.0354141],[23.8767345,-17.8180568],[23.7771921,-17.6038235],[23.6747639,-17.3927906],[23.5694383,-17.18504],[23.4611992,-16.9806608],[23.3500245,-16.7797504],[23.2358854,-16.5824162],[23.1187445,-16.3887783],[22.998554,-16.1989719],[22.8752527,-16.013152],[22.7487623,-15.8314989],[22.6189816,-15.6542266],[22.4857779,-15.4815953],[22.5929965,-15.3247026],[22.6991204,-15.1670674],[22.8041445,-15.0086972],[22.9080637,-14.8495999],[23.118529,-14.906601],[23.3319723,-14.9586635],[23.5482036,-15.0060098],[23.7670642,-15.0488151],[23.9884173,-15.087221],[24.2121433,-15.121343],[24.4381355,-15.1512773],[24.6662972,-15.1771042],[24.8965403,-15.1988916],[25.1287832,-15.216697],[25.3629498,-15.2305695],[25.5989687,-15.2405512],[25.8367724,-15.2466781],[25.9090608,-15.1235104],[25.9807621,-15.0],[26.0518746,-14.8761497],[26.1223968,-14.7519622],[25.9981888,-14.5490816],[25.871535,-14.3496741],[25.7424377,-14.1538161],[25.6108964,-13.9615906],[25.4769064,-13.7730879],[25.3404588,-13.5884075],[25.2015389,-13.4076597],[25.0601253,-13.2309683],[24.9161883,-13.0584738],[24.7696875,-12.8903377],[24.6205688,-12.7267489],[24.4687596,-12.567933],[24.3141626,-12.4141652],[24.3999853,-12.2446198],[24.4846258,-12.0744812],[24.56808,-11.9037576],[24.6503438,-11.7324572],[24.8664487,-11.7614994],[25.0848614,-11.7852566],[25.3054228,-11.8039739],[25.5279982,-11.8178461],[25.7524706,-11.8270309],[25.9787364,-11.8316589],[26.2067024,-11.8318392],[26.4362832,-11.8276641],[26.6674004,-11.8192123],[26.8999804,-11.8065516],[27.1339544,-11.7897406],[27.3692571,-11.7688303],[27.605826,-11.7438651],[27.6614194,-11.6123156],[27.716386,-11.480503],[27.7707244,-11.3484301],[27.8244335,-11.2161001],[27.6748069,-11.0311676],[27.5232087,-10.8499977],[27.3696513,-10.6726659],[27.2141448,-10.4992544],[27.0566967,-10.3298536],[26.8973107,-10.1645632],[26.735987,-10.0034944],[26.5727204,-9.8467728],[26.4074997,-9.6945416],[26.2403061,-9.5469661],[26.0711105,-9.4042408],[25.8998704,-9.2665985],[25.7265253,-9.1343252],[25.7894837,-8.9550282],[25.8511925,-8.7752974],[25.9116488,-8.5951414],[25.9708496,-8.4145689],[26.1888965,-8.4151552],[26.4085416,-8.4102006],[26.6296592,-8.3999688],[26.8521411,-8.3846703],[27.075892,-8.3644771],[27.3008261,-8.3395319],[27.5268653,-8.3099552],[27.7539371,-8.2758494],[27.9819739,-8.2373031],[28.2109116,-8.1943929],[28.4406897,-8.147186],[28.6712499,-8.0957414],[28.9025364,-8.0401114],[28.9404835,-7.9024309],[28.9777748,-7.7645714],[29.0144094,-7.6265358],[29.0503864,-7.4883275],[28.8779014,-7.3245072],[28.7039527,-7.1646748],[28.5285626,-7.0089034],[28.3517518,-6.8572732],[28.1735393,-6.7098727],[27.9939422,-6.5668004],[27.8129749,-6.4281666],[27.6306488,-6.2940963],[27.4469715,-6.164733],[27.2619458,-6.0402432],[27.0755682,-5.9208234],[26.8878273,-5.80671],[26.6987,-5.6981944],[26.7377168,-5.5122136],[26.7754382,-5.3259658],[26.8118622,-5.1394599],[26.846987,-4.952705],[27.063245,-4.9248255],[27.2803643,-4.8912438],[27.4982547,-4.8522379],[27.7168364,-4.8080306],[27.9360373,-4.7588048],[28.1557911,-4.7047132],[28.376036,-4.6458854],[28.5967135,-4.5824327],[28.817768,-4.5144514],[29.0391463,-4.4420259],[29.2607968,-4.3652308],[29.4826696,-4.2841321],[29.7047163,-4.1987891],[29.7243679,-4.0573334],[29.7433458,-3.9157858],[29.7616498,-3.7741494],[29.7792792,-3.6324275],[29.586887,-3.4925226],[29.3935642,-3.3567623],[29.1993422,-3.2252166],[29.0042524,-3.097962],[28.8083249,-2.975084],[28.6115896,-2.8566778],[28.4140752,-2.742851],[28.2158092,-2.6337261],[28.016818,-2.5294442],[27.817126,-2.4301701],[27.6167555,-2.3360991],[27.4157259,-2.2474671],[27.2140525,-2.1645659],[27.2284602,-1.9750835],[27.2415486,-1.7855054],[27.2533171,-1.5958408]]);}
