daffa261109/twotrash/(list of files, cad)

Other CAD files:
docs/3d/external-gears/stl/base_left.stl
docs/3d/external-gears/stl/referensi/pinion_pan_fastener.stl
docs/3d/external-gears/flap-shape-library.scad
