daffa261109/twotrash/trash2trace/settings.py

"""Pengaturan mesin. Sudut ada di STATIONS. Token API diisi lewat file .env."""

from __future__ import annotations

import os
from dataclasses import dataclass
from pathlib import Path

ROOT = Path(__file__).resolve().parent.parent
ENV_PATH = ROOT / ".env"
STATION_PATH = ROOT / "station.txt"
MODEL_PATH = ROOT / "models" / "mobilenet_v3_small.tflite"
LABEL_PATH = ROOT / "models" / "imagenet_labels.txt"
CAPTURE_DIR = ROOT / "captures"
# Flap tidak digerakkan. Hasil model hanya ditulis ke log dulu.
MOVE_FLAP = False

CAMERA_SIZE = (640, 480)  # USB MJPEG; unggahan API tetap dikecilkan terpisah.
MIN_CONFIDENCE = 0.60
SETTLE_AFTER_DETECT_S = 0.18
# Setelah HC melihat sampah, layar menghitung mundur selama ini baru foto dikirim.
PLACE_WAIT_S = 3.0
MONITOR_PORT = 8080
# Satu foto per sampah, dibaca API bridge.
FRAMES_PER_DECISION = 1
FRAME_GAP_S = 0.07
SERVO_HOLD_S = 1.45
PREVIEW_EVERY_S = 1.0

OLED_WIDTH = 128
OLED_HEIGHT = 64
OLED_ADDR = 0x3C
# True kalau OLED terpasang terbalik: tampilan diputar 180 derajat.
OLED_FLIP = True
# Layar sambutan setelah Wi-Fi terhubung. Teks bawah berjalan dari kanan ke kiri.
WELCOME_TITLE = "TRASH2TRACE"
WELCOME_SCROLL = "Buang sampah pada tempatnya"
WIFI_INTERFACE = "wlan0"
# Foto ke API dikecilkan dulu supaya unggahan lebih cepat.
LLM_IMAGE_WIDTH = 320
BRIDGE_TIMEOUT_S = 45
SORT_SETTLE_S = 1.0
TILT_DOWN_DEG = -45.0
TILT_HOLD_S = 1.5
TILT_UP_SETTLE_S = 1.0
SORT_WAIT_S = 3.0
LLM_IMAGE_QUALITY = 70
ROI = (0.08, 0.05, 0.84, 0.90)


@dataclass(frozen=True)
class Station:
    """Satu Pi, satu flap. Sudut diukur dari posisi tengah servo."""

    name: str
    title: str
    organic: float
    nonorganic: float
    other: float

    def angle_for(self, label: str) -> float:
        if label == "organic":
            return self.organic
        if label == "nonorganic":
            return self.nonorganic
        return self.other

    def text_for(self, label: str) -> str:
        if label == "organic":
            return "ORGANIK"
        return "NONORGANIK"


# Negatif = kiri, positif = kanan, 0 = tengah.
STATIONS = {
    "flap1": Station("flap1", "FLAP 1", organic=-60.0, nonorganic=60.0, other=0.0),
    "flap2": Station("flap2", "FLAP 2", organic=-60.0, nonorganic=60.0, other=0.0),
}


@dataclass(frozen=True)
class BridgeConfig:
    endpoint: str
    token: str


def load_bridge_config() -> BridgeConfig:
    _load_env_file(ENV_PATH)
    config = BridgeConfig(
        endpoint=os.environ.get("API_ENDPOINT", "https://twotrash.wbesoft.com/classify").strip(),
        token=os.environ.get("API_TOKEN", "").strip(),
    )
    if not config.token:
        raise SystemExit("Isi API_TOKEN di file .env, sama dengan token di server.")
    return config


def _env_flag(name: str, default: bool) -> bool:
    raw = os.environ.get(name, "").strip().lower()
    if not raw:
        return default
    return raw in {"1", "true", "ya", "yes", "on"}


def _env_float(name: str, default: float) -> float:
    raw = os.environ.get(name, "").strip()
    if not raw:
        return default
    try:
        return float(raw)
    except ValueError:
        print(f"[WARN] {name}={raw!r} bukan angka, dipakai {default:g}")
        return default


def _load_env_file(path: Path) -> None:
    if not path.exists():
        return
    for line in path.read_text(encoding="utf-8").splitlines():
        line = line.strip()
        if not line or line.startswith("#") or "=" not in line:
            continue
        key, value = line.split("=", 1)
        os.environ.setdefault(key.strip(), value.strip().strip('"').strip("'"))


def load_station(name: str | None) -> Station:
    if name is None and STATION_PATH.exists():
        name = STATION_PATH.read_text(encoding="utf-8").strip().split()[0]
    station_name = (name or "flap1").lower()
    try:
        return STATIONS[station_name]
    except KeyError as exc:
        known = ", ".join(STATIONS)
        raise SystemExit(f"station harus salah satu dari: {known}") from exc


# Setelah jawaban API: servo 1 ke tempat sampah, jeda, servo 2 buang, jeda, lalu keduanya kembali.
# Kecepatan dalam derajat per detik. Angka di .env supaya bisa diubah tanpa menyentuh kode.
_load_env_file(ENV_PATH)
# Jendela monitor di Pi Zero berat. SHOW_MONITOR=1 di .env kalau ingin dinyalakan lagi.
SHOW_MONITOR = _env_flag("SHOW_MONITOR", False)
SERVO_KECEPATAN = _env_float("SERVO_KECEPATAN", 45.0)
SERVO1_WAIT_S = _env_float("SERVO1_TUNGGU", 2.0)
SERVO2_WAIT_S = _env_float("SERVO2_TUNGGU", 3.0)
SERVO2_BUANG = _env_float("SERVO2_BUANG", 150.0)
SERVO2_NONORGANIK = _env_float("SERVO2_NONORGANIK", -45.0)
SERVO2_ORGANIK = _env_float("SERVO2_ORGANIK", -60.0)
SERVO2_LAINNYA = _env_float("SERVO2_LAINNYA", 145.0)
SERVO1_ORGANIK = _env_float("SERVO1_ORGANIK", 180.0)
SERVO1_NONORGANIK = _env_float("SERVO1_NONORGANIK", -90.0)
SERVO1_KEMBALI = _env_float("SERVO1_KEMBALI", 60.0)
SERVO2_KEMBALI = _env_float("SERVO2_KEMBALI", 45.0)
SERVO1_ANGLES = {
    "organic": SERVO1_ORGANIK,
    "nonorganic": SERVO1_NONORGANIK,
}
SERVO2_ANGLES = {
    "organic": SERVO2_ORGANIK,
    "nonorganic": SERVO2_NONORGANIK,
    "other": SERVO2_LAINNYA,
}
SORT_ANGLES = dict(SERVO1_ANGLES)

# Jarak dalam sentimeter. 56–58 cm = penampang kosong. Lebih dekat dari itu = ada barang.
HC_BARANG_MIN_M = _env_float("HC_BARANG_MIN", 2.0) / 100.0
HC_PENAMPANG_MIN_M = _env_float("HC_PENAMPANG_MIN", 56.0) / 100.0
HC_PENAMPANG_MAX_M = _env_float("HC_PENAMPANG_MAX", 58.0) / 100.0
HC_BARANG_YAKIN = 10
DETECT_MIN_M = HC_BARANG_MIN_M
DETECT_MAX_M = HC_PENAMPANG_MIN_M
CLEAR_DISTANCE_M = HC_PENAMPANG_MIN_M


def is_penampang(distance_m: float) -> bool:
    """Hanya penampang kosong, tanpa sampah di atasnya."""
    return HC_PENAMPANG_MIN_M <= distance_m <= HC_PENAMPANG_MAX_M


def is_barang(distance_m: float) -> bool:
    """Benda di depan penampang: lebih dekat dari batas penampang."""
    return HC_BARANG_MIN_M <= distance_m < HC_PENAMPANG_MIN_M


def is_kosong(distance_m: float) -> bool:
    """Tidak ada sampah. Penampang atau lebih jauh, selain pantulan habis waktu."""
    return HC_PENAMPANG_MIN_M <= distance_m < 1.9


def baca_barang(streak: int, distance_m: float) -> tuple[int, bool]:
    """Ada barang hanya setelah jarak dekat terbaca terus sebanyak HC_BARANG_YAKIN."""
    streak = streak + 1 if is_barang(distance_m) else 0
    return streak, streak >= HC_BARANG_YAKIN
