daffa261109/twotrash/trash2trace/llm.py

"""Mengirim foto sampah ke LLM yang OpenAI-compatible."""

from __future__ import annotations

import base64
import json
import re
import urllib.error
import urllib.request

from trash2trace.labels import canonical_class
from trash2trace.settings import LLM_IMAGE_QUALITY, LLM_IMAGE_WIDTH, LlmConfig, load_llm_config

_PROMPT = (
    "Classify the waste in this photo as exactly one label: "
    "organic, nonorganic, or other. "
    'Reply with JSON only: {"label":"organic","confidence":0.0}'
)


class LlmVision:
    def __init__(self, config: LlmConfig | None = None) -> None:
        self.config = config or load_llm_config()
        print(
            f"[INFO] LLM {self.config.provider} model={self.config.model} "
            f"endpoint={self.config.endpoint}"
        )

    def classify(self, jpeg: bytes) -> tuple[str, float]:
        jpeg = _shrink(jpeg)
        payload = {
            "model": self.config.model,
            "temperature": 0,
            "messages": [
                {
                    "role": "user",
                    "content": [
                        {"type": "text", "text": _PROMPT},
                        {
                            "type": "image_url",
                            "image_url": {"url": _data_url(jpeg), "detail": "low"},
                        },
                    ],
                }
            ],
        }
        request = urllib.request.Request(
            _chat_url(self.config.endpoint),
            data=json.dumps(payload).encode("utf-8"),
            headers={
                "Authorization": f"Bearer {self.config.api_key}",
                "Content-Type": "application/json",
            },
            method="POST",
        )
        try:
            with urllib.request.urlopen(request, timeout=45) as response:
                body = response.read().decode("utf-8")
        except urllib.error.HTTPError as exc:
            detail = exc.read().decode("utf-8", errors="replace")[:300]
            raise RuntimeError(f"LLM menolak permintaan ({exc.code}): {detail}") from exc
        except urllib.error.URLError as exc:
            raise RuntimeError(f"LLM tidak terjangkau: {exc.reason}") from exc
        return _parse_reply(body)


def list_models(config: LlmConfig) -> list[str]:
    """Cek koneksi dan kunci ke Sumopod. Mengembalikan daftar model."""
    request = urllib.request.Request(
        config.endpoint.rstrip("/") + "/models",
        headers={"Authorization": f"Bearer {config.api_key}"},
    )
    try:
        with urllib.request.urlopen(request, timeout=20) as response:
            data = json.loads(response.read().decode("utf-8"))
    except urllib.error.HTTPError as exc:
        raise RuntimeError(f"Server menjawab {exc.code}. Cek LLM_API_KEY di .env.") from exc
    except urllib.error.URLError as exc:
        raise RuntimeError(f"Server tidak terjangkau: {exc.reason}") from exc
    return [str(item.get("id")) for item in data.get("data", [])]


def _chat_url(endpoint: str) -> str:
    endpoint = endpoint.rstrip("/")
    if endpoint.endswith("/chat/completions"):
        return endpoint
    return endpoint + "/chat/completions"


def _shrink(jpeg: bytes) -> bytes:
    """Kecilkan foto sebelum dikirim. Unggahan kecil lebih cepat di Pi Zero."""
    try:
        import cv2
        import numpy as np

        image = cv2.imdecode(np.frombuffer(jpeg, dtype=np.uint8), cv2.IMREAD_COLOR)
        if image is None:
            return jpeg
        height, width = image.shape[:2]
        if width > LLM_IMAGE_WIDTH:
            image = cv2.resize(
                image,
                (LLM_IMAGE_WIDTH, round(height * LLM_IMAGE_WIDTH / width)),
                interpolation=cv2.INTER_AREA,
            )
        ok, encoded = cv2.imencode(".jpg", image, [int(cv2.IMWRITE_JPEG_QUALITY), LLM_IMAGE_QUALITY])
        return encoded.tobytes() if ok else jpeg
    except Exception:
        return jpeg


def _data_url(jpeg: bytes) -> str:
    encoded = base64.b64encode(jpeg).decode("ascii")
    return f"data:image/jpeg;base64,{encoded}"


def _parse_reply(body: str) -> tuple[str, float]:
    data = json.loads(body)
    content = data["choices"][0]["message"]["content"]
    if isinstance(content, list):
        text = "".join(
            part.get("text", "") for part in content if isinstance(part, dict)
        )
    else:
        text = str(content)
    match = re.search(r"\{.*\}", text, flags=re.DOTALL)
    if match is None:
        raise RuntimeError(f"Jawaban LLM bukan JSON: {text[:200]}")
    reply = json.loads(match.group(0))
    label = canonical_class(str(reply.get("label", "other")))
    try:
        confidence = float(reply.get("confidence", 0.0))
    except (TypeError, ValueError):
        confidence = 0.0
    return label, min(1.0, max(0.0, confidence))
