daffa261109/twotrash/motor/pins.py

"""Pin BCM yang dipakai program. Angka physical ada di docs/wiring.md."""

# L298N ENA — PWM kecepatan. Physical pin 12.
ENABLE_PIN = 18

# L298N IN1 — high saat maju. Physical pin 11.
FORWARD_PIN = 17

# L298N IN2 — high saat mundur. Physical pin 13.
BACKWARD_PIN = 27
