daffa261109/twotrash/(commit log)

2026-10-07 Tambah kontrol servo MG996R untuk Pi Zero
2026-10-07 Sesuaikan pin dan dokumentasi dengan wiring lengkap Pi Zero.
2026-10-08 Perbaiki sensor jarak yang membuat pemilah berhenti saat mulai.
2026-10-11 Tambah pratinjau kamera Pi Zero yang bisa dibuka di browser.
2026-10-11 Tampilkan jenis sampah dari Sumopod di samping pratinjau kamera.
2026-10-11 Baca sampah dengan MobileNet di Pi dan catat hasilnya dulu sebelum flap digerakkan.
2026-10-11 Muat libatomic supaya interpreter TFLite di Pi Zero bisa diimpor.
2026-10-11 Bunyi buzzer saat sensor jarak melihat benda.
    [sorter.py]
2026-10-11 Catat organic, nonorganic, atau other saat benda ada di 1–3 cm.
2026-10-11 Nyalakan buzzer, lampu, dan OLED saat sensor melihat benda, tanpa memotret.
    [pins.py, sorter.py]
2026-10-11 Tambah uji terpisah untuk buzzer, sensor jarak, LED, dan lampu.
    [test_parts.py]
2026-10-11 Tambah uji servo ke kiri, tengah, dan kanan.
2026-10-13 Baca jarak dua kali saat ada barang, dan bunyikan buzzer sekali jika 4,5 cm atau lebih.
2026-10-13 Baca jarak dua kali di program utama, dan nyalakan lampu hanya selama barang ada.
2026-10-13 Nyalakan lampu penerangan dengan pin yang sama seperti uji, selama sampah masih ada.
2026-10-13 Ambil satu foto sampah pada saat yang sama dengan bacaan sensor.
2026-10-15 Catat susunan baru: servo dan catu di bawah, elektronik di kotak atas.
2026-10-15 Tambah model 3D flap 300x350 mm dan penjelasan isi PCB lubang.
2026-10-17 Tambah diagram daya dan sinyal untuk 1 Pi dengan 2 servo.
2026-10-18 Tambah tata letak PCB 6x28 dan ubah pembagi ECHO ke 2,2k dan 2,7k.
2026-10-18 Tambah uji cincin WS2812 di test_parts.
2026-10-18 Pisahkan uji servo 1 dan servo 2, tambah pin servo miring.
2026-10-18 Tambah uji kamera dengan cincin putih dan paket pigpio di install.sh.
2026-10-18 Status boot: LED merah, hijau saat Wi-Fi terhubung, OLED sambutan berjalan
2026-10-18 Servo stabil lewat pigpio, tambah tes servo1_kanan90
2026-10-23 Tambah skrip cek posisi servo 1 dan 2
2026-10-23 Preview web: kontrol cincin LED dan tes API Sumopod; cek_servo beri petunjuk
2026-10-23 Preview: gerakkan servo 1 dan 2 setelah Sumopod membaca sampah
2026-10-23 Preview: tombol Tes API ikut menggerakkan servo
2026-10-24 Tambah tes urutan servo (urut_kiri, urut_kanan)
2026-10-25 Uji servo 2 ke 25° lalu kembalikan ke rata.
2026-10-25 Uji servo 2 turun 25° lalu kembali, bukan ke arah yang mentok.
2026-10-25 Tampilkan webcam langsung di browser lewat webcam --live.
2026-10-26 Kunci desain flap Rev G dan gunakan kamera USB
    Simpan rakitan gear luar 3:1, STL, viewer, serta baseline desain flap kosong; catat penghapusan file lama oleh pengguna.
    Tambahkan backend kamera USB/CSI beserta 9 pengujian. Dependensi flap-shape-library.scad dan render_pan_tilt.py ikut dihapus pengguna, sehingga regenerasi CAD memerlukan pemulihan kedua file tersebut. Referensi Pan-Tilt-Mount merupakan repositori terpisah dan tidak disertakan.
2026-10-26 Satukan dependensi CAD Rev G dalam external-gears
    Pulihkan pustaka flap dan renderer CPU lokal, arahkan include/import serta seluruh keluaran build ke dalam folder yang sama, dan sesuaikan dokumentasi serta manifest baseline.
    Validasi: build lengkap berhasil; semua 20 STL identik dengan baseline Rev G; dependensi CAD dan tautan dokumentasi valid.
2026-10-26 Tambahkan PCB Pi Zero DRV8825 dan finalisasi pinion Rev G1
2026-10-26 Perjelas peta komponen PCB dan tambahkan Excel checklist belanja
2026-10-26 Perbarui PCB ke revisi TT-PZ2 tanpa ring LED dan IC buffer.
2026-10-26 Tambahkan flap dengan kaki servo menggantung sesuai braket U.
2026-10-26 Tipiskan dinding piring jadi 2 mm dan kaki servo jadi 3 mm.
2026-10-30 Kembalikan wiring servo Pi Zero dan ganti HC serta cincin dengan infrared E18-D80NK.
    Tidak ada rel 5 V AUX, jadi sensor mengambil 5 V dari pin Pi dan servo tetap pada catu rak bawah.
2026-10-30 Beri daya servo dari catu 6 V 5 A dan ganti MG996R rusak dengan TD8120MG.
    Kenop adaptor harus di 6,0 V sebelum kabel merah dipasang, dan rel itu tidak masuk ke pin 5 V Pi.
2026-10-30 Sesuaikan sinyal E18 dengan 4,7 kΩ yang sudah terpasang, lalu 1 kΩ dan 10 kΩ.
    Header Pi Zero ikut digambar supaya kabel oranye servo langsung ke GPIO dan kaki hitam tidak tertukar.
2026-10-30 Tahan servo 1 di 60 derajat saat tes servo dinyalakan.
    Urutan kiri-tengah-kanan membuat posisi akhir tidak tetap.
2026-10-30 Gerakkan tes servo ke 180 derajat, tunggu 5 detik, lalu kembali ke 60.
    Pulsa 60 derajat tetap sama supaya posisi akhir tidak bergeser.
2026-10-30 Gerakkan tes servo ke 0 derajat, tunggu 5 detik, lalu kembali ke 60.
2026-10-30 Gerakkan tes servo ke -60 derajat, tunggu 5 detik, lalu kembali ke 60.
    Arah di bawah nol memakai sisa perjalanan servo yang kurang dari 180 derajat.
2026-10-30 Gerakkan tes servo ke -90 derajat, tunggu 5 detik, lalu kembali ke 60.
2026-10-30 Gerakkan servo 1 dari jawaban API memakai sudut dan jeda di .env.
2026-10-30 Tahan tes servo 2 di 60 derajat sampai dihentikan.
2026-10-30 Gerakkan tes servo 2 ke -60 derajat, tunggu 5 detik, lalu kembali ke 60.
2026-10-30 Gerakkan tes servo 2 ke 180 derajat, tunggu 5 detik, lalu kembali ke 60.
2026-10-30 Pelankan tes servo 2 ke 150 derajat, lalu kembali ke 60.
2026-10-30 Pelankan tes servo 1 ke -90 derajat, lalu kembali ke 60.
2026-10-30 Gerakkan kedua servo pelan setelah jawaban API, dengan kecepatan dan sudut buang di .env.
2026-10-30 Tampilkan angka mentah pin pada tes infrared.
2026-10-30 Kembalikan diagram dan wiring ke HC-SR04.
2026-10-30 Anggap jarak 56–58 cm hanya penampang kosong pada sensor HC.
2026-10-30 Tampilkan jenis sampah dan nama barang dari API di OLED.
2026-10-30 Kembalikan OLED dan sensor siap setelah sampah selesai dibuang.
2026-11-01 Matikan jendela monitor yang berat dan nyalakan LED merah lebih dulu.
2026-11-01 Kembalikan servo 2 ke posisi awal pada tes komponen.
2026-11-01 Kembalikan servo 2 ke 45 derajat lewat SERVO2_KEMBALI.
2026-11-01 Izinkan tes servo 1 menerima derajat lewat --sudut.
2026-11-01 Tahan tes servo 1 di sudut uji dan pisahkan perintah kembali.
2026-11-01 Izinkan tes servo 2 menerima derajat lewat --sudut.
2026-11-01 Tambahkan tes servo2_kembali untuk pulang pelan ke posisi awal.
2026-11-01 Atur sudut buang servo per kategori sampah.
